FrissieKris/Eng_DesignProject_GantryCrane_Group-18/README.md

MCTR \
--Juan Fourie     -->   Pulley Mechanism \
--Romeo Mapasa    -->   Lateral Movement \
EEII \
--Jopie Roux      --> \
--JP Smith        --> \
REII  \
--Anton Swanepoel --> \
