FrissieKris/Eng_DesignProject_GantryCrane_Group-18/EngineeringDesign_Group18_Report/content/00_abstract.tex

% ── Abstract ────────────────────────────────────────────────
% The Abstract environment (defined in NWUStyle.sty):
%   • adds "Abstract" to the TOC
%   • sets page counter to 1 with roman numerals
%   • clears the page afterwards
\begin{Abstract}{}

This report presents the design, development, and testing of a gantry crane system for the transportation of steel metal sheets along a track.

\KeyWords{Pulley; Gantry Crane; Electro-magnet; Gearbox Design}

\end{Abstract}
