FrissieKris/Eng_DesignProject_GantryCrane_Group-18/EngineeringDesign_Group18_Report/content/04_interfaces.tex

% ============================================================
%  CHAPTER 4 – INTERFACES
% ============================================================
\chapter{Interface Control}
\label{ch:interface-control}
This chapter describes each of the interfaces introduced in chapter~\ref{ch:system-design}. Each interface listed in section~\ref{sec:summary-of-interfaces}, is described and allocated to a role in section~\ref{sec:work-allocation}.

\section{Work Allocation}
\label{sec:work-allocation}
This section ascribes each interface is the responsibility of the role under which it is described. Each member read and confirmed their responsibilities and interfaces under their jurisdiction as indicated below. By having their name printed next to their role they have accepted the responsibility and are the liable person for all interfaces listed in their section.

\subsection{EERI I:  }
\label{subsec:eeri1-interfaces}
EERI I Drive Electroncics by Jopie Roux.

Table \ref{tab1:interfaces-eeri1} and \ref{tab2:interfaces-eeri1} define the the external inteerfaces that 
cross the boundary of the drive electronics (F/U 1.1) and the internal interfaces bewtween
its level 2 functional units. The interface type letters correspond to figure \ref{fig:arch-eeri1}, where E denotes
electrical interfaces, S signal interfaces and M mechanical interfaces. 
The drive-electronics subsystem receives single-phase AC, distributes protected power to the 
required PSUs, receives control signals from REII, and supplies the three-phase induction 
motor used by MCTR II. It also returns conditioned current feedback to the controller and provides local 
hardware protection of the inverter.

\begin{table}[H]
    \centering
    \caption{External interfaces of EEII I (F/U 1.1, Level 1).}
    \label{tab1:interfaces-eeri1}

    \begin{tabularx}{\textwidth}{@{} l l l X @{}}
        \toprule
        \textbf{Interface} & \textbf{From} & \textbf{To} & \textbf{Description} \\
        \midrule

        I/F 1.0 E & F/U 2.0 & F/U 1.1.1 &
        Single-phase 230 VAC, 50 Hz mains input to the drive electronics. The input is routed through the required main switching and protection using 15 A trip switches before being distributed to the rest of the system. \\

        I/F 1.2 E & F/U 1.1.1 & F/U 1.2 &
        Protected mains supply to the 12 VDC power supply. \\

        I/F 1.6 E & F/U 1.1.1 & F/U 1.4 &
        Protected mains supply to the 12 VDC power supply. \\

        I/F 1.5 S & F/U 1.1 & F/U 1.1 &
        Control and feedback interface between the REII controller and the drive electronics. The controller provides isolated PWM signals used by the driver ICs to switch the DC bus voltage. EEII I returns a current-sense signal via an ACS72981xLR Hall-effect current sensor. The output voltage is limited below 2.048 V. \\

        I/F 1.7 E & F/U 1.1.5 & F/U 1.7 &
        Three-phase AC from the inverter to the 180 W induction motor. \\

        I/F 1.8 M & F/U 1.7 & F/U 1.3.1 &
        Mechanical transfer of motor torque from the 11 mm motor shaft to MCTR II's gearbox input. \\

        \bottomrule
    \end{tabularx}
\end{table}

\begin{table}[H]
    \centering
    \caption{Internal interfaces of EEII I (F/U 1.1, Level 2).}
    \label{tab2:interfaces-eeri1}

    \begin{tabularx}{\textwidth}{@{} l l l X @{}}
        \toprule
        \textbf{Interface} & \textbf{From} & \textbf{To} & \textbf{Description} \\
        \midrule

        I/F 1.1.1 E & F/U 1.1.1 & F/U 1.1.2 &
        Protected single-phase 230 VAC supplied to the rectifier stage after the system protection and switching
        devices.\\

        I/F 1.1.2 E & F/U 1.1.2 & F/U 1.1.3 &
        High voltage rectified DC supplied to the DC bus for smoothing with a bulk capacitor.\\

        I/F 1.1.3 E & F/U 1.1.3 & F/U 1.1.5 &
        Smooth HV DC voltage supplied to the 6 switch inverter.\\

        I/F 1.1.4 S & F/U 1.1.4 & F/U 1.1.5 &
        Isolated PWM signals used to contorl the IGBT switching. The IR2104 gate driver ICs are used to switch
        the IGBTs using the provided PWM signal. Between the REII controller and the IR2104s a optocoupler is 
        inserted to ensure electrical isolation.\\

        I/F 1.1.5 S & F/U 1.1.5 & F/U 1.1.6 &
        Inverter operating current information sent to the sensing and protection stage using a 
        ACS72981xLR Hall-effect current sensor. This path is used to detect a overcurrent or shoot-through fault 
        and initialte a local inverter shutdown.\\

        I/F 1.1.6 E & F/U 1.2 & F/U 1.1.4 &
        12VDC used to power the driver ICs obtained from EEII II's PSU. \\

        \bottomrule
    \end{tabularx}
\end{table}

The main power path flows from the protected mains to the bridge rectifier, to the DC bus for smoothing using a bulk
capacitor to supply the 3-phase inverter. In parallel, a 12VDC PSU powers the gate driver ICs which use the isolated 
PWM singals from REII to switch the IBTSs and create the 3-phase AC for the induction motor. The EEII I subsystem
also provides a current-sense signal to REII for feedback and local protection of the inverter. 

\subsection{EERI II: Magnetic Load Attachment Interfaces}
\label{subsec:eeri2-interfaces}
The EERI II subsystem interfaces with the embedded controller, the main power distribution, the hoisting assembly, and the physical electromagnet.
The interface allocations are the work of J.P. Smith and are detailed in Tables~\ref{tab:interfaces-eeri2} (Level~1 external interfaces) and~\ref{tab:interfaces-eeri2-internal} (Level~2 internal interfaces).
Power enters via I/F~1.2~E from the EEII~I power supply $+13.5\,\text{V}$ DC to the switching circuit and electromagnet coils.
The physical assembly is suspended from the MCTR~II hoisting system via mechanical interface I/F~1.3~M.
Command and feedback signals are exchanged with the REII ESP32-S3 controller across I/F~1.10~S, which carries PWM gate switching command and returns the analog current-sense signal ($V_{\mathrm{ISENSE}} \le 2.048\,\text{V}$).
Internally, the driver stage switches the coils over I/F~1.2.1~E,
the current passes through the ACS712 sensor over I/F~1.2.2~E,
and regulated $+5\,\text{V}$ and ground are shared between the switching and analog conditioning circuit over I/F~1.2.3~E.
Finally, electromagnetic force ($\ge 268.68\,\text{N}$) is applied to the 20\,kg metal plate across mechanical interface I/F~5.0~M.
\begin{table}[H]
    \centering
    \caption{External interfaces of EERI II (F/U 1.2, Level 1).}
    \label{tab:interfaces-eeri2}
    \begin{tabularx}{\textwidth}{@{} l l l X @{}}
        \toprule
        \textbf{Interface} & \textbf{From} & \textbf{To} & \textbf{Description} \\
        \midrule
        I/F 1.2 E  & F/U 1.1.1 & F/U 1.2.2 & $+13.5\,\text{V}$ DC power supply rail and ground from EEII I, rated for $100\,\text{W}$. \\
        I/F 1.3 M  & F/U 1.4   & F/U 1.2.1 & Mechanical connection between the electromagnet and the MCTR II hoist cable. \\
        I/F 1.10 S & F/U 1.5   & F/U 1.2   & Control and feedback interface with the REII controller, 3.3\,V PWM switching command to F/U 1.2.2 and a conditioned analog current-sense signal ($V_{\mathrm{ISENSE}} \le 2.048\,\text{V}$) from F/U 1.2.3. \\
        I/F 5.0 M  & F/U 1.2.1 & Payload   & Electro magnet - Plate interface with $\ge 268.68\,\text{N}$ of holding force across the 3 U cores, 6 poles, on the 20\,kg flat steel plate (PHY1). \\
        \bottomrule
    \end{tabularx}
\end{table}

\begin{table}[H]
    \centering
    \caption{Internal interfaces of EERI II (F/U 1.2, Level 2).}
    \label{tab:interfaces-eeri2-internal}
    \begin{tabularx}{\textwidth}{@{} l l l X @{}}
        \toprule
        \textbf{Interface} & \textbf{From} & \textbf{To} & \textbf{Description} \\
        \midrule
        I/F 1.2.1 E & F/U 1.2.2 & F/U 1.2.1 & Switched driver delivering up to 3.1\,A at 13.5\,V) from the IRF540Z low-side switch to the 6 series coils. \\
        I/F 1.2.2 E & F/U 1.2.1 & F/U 1.2.3 & Coil current through the ACS712-30A Hall-effect sensor. \\
        I/F 1.2.3 E & F/U 1.2.2 & F/U 1.2.3 & Regulated $+5\,\text{V}$ DC and analog ground powering the ACS712 sensor and LM358 opamp stages. \\
        \bottomrule
    \end{tabularx}
\end{table}

\subsection{MCTR I: Romeo Mapasa }
\label{subsec:mctr1-interfaces}
MCTR I Lateral Movement by Romeo Mapasa.
\begin{table}[H]
    \centering
    \caption{Operational Interfaces.}
    \label{tab:interfaces-mctr1}
    \begin{tabular}{@{} l l l p{5cm} @{}}
        \toprule
        \textbf{Interface} & \textbf{From} & \textbf{To} & \textbf{Description} \\
        \midrule
        I1 & F/U 1.0 & F/U 2.0 & [Description of data/power/signal.] \\
        I2 & F/U 2.0 & F/U 3.0 & [Description.] \\
        \bottomrule
    \end{tabular}
\end{table}

\subsection{MCTR II: Juan Fourie}
\label{subsec:mctr2-interfaces}
MCTR II Spooling by Juan Fourie.
\input{content/0p0_mctr2_parameters}

% ---- INSERTED FROM DRAWINGS: Level 1 and Level 2 (MCTR II) -------------
Tables~\ref{tab:interfaces-mctr2} and~\ref{tab:interfaces-mctr2-internal} list every interface that crosses the
MCTR II boundary (Level 1 numbering) and every interface between its internal
functional units (Level 2 numbering). The type letter follows the drawing:
M = mechanical, E = electrical, S = signal. Entries marked
\textcolor{red}{TBD} remain to be confirmed against subsequent design drawings and tests.
 
\begin{table}[H]
    \centering
    \caption{External interfaces of MCTR II (F/U \fuMII, Level 1).}
    \label{tab:interfaces-mctr2}
    \footnotesize
    \renewcommand{\arraystretch}{1.25}
    \begin{tabularx}{\textwidth}{@{} l p{2.6cm} p{1.6cm} X @{}}
        \toprule
        \textbf{Interface} & \textbf{From} & \textbf{To} & \textbf{Description and key parameters} \\
        \midrule
        I/F 1.1 M & F/U 1.3 & F/U \fuMII &
            Bolted mounting of the of the loadcell with pulley to MCTR I. Plate carries the rope reaction of
            \showv{FropeD}{0}{N} (design case). Preliminary design will be M12 bolt hole for eyebolts. This interface also includes the mounting of the gearbox to be mounted on MCTR I. Final gearbox dimensions \tbd{Gearbox Dimensions} \\
        I/F 1.3 M & F/U \fuMII.4 (rope) & F/U 1.2 &
            Rope termination to the magnetic load attachment. Rated payload
            \InMassRated\,kg plus attachment 10kg conservative headroom for EEII II components. \\
        I/F 1.7 E & F/U 1.1 & F/U \fuMII &
            3-phase power to the induction motor from the VSD
            (\InMotorP\,W, \InMotorN\,rpm at \InMotorF\,Hz). Frequency designed for is 30Hz, 816Rom for reduction ratio of 26.7:1. Delivered
            frequency \tbd{Hz}. Mains feed to the Brake PSU. \\
        I/F 1.8 M & F/U 1.1 (motor) & F/U \fuMII.1 &
            Motor shaft (11\,mm, $4\times16$\,mm keyway) to gearbox input
            shaft (\InShaftD\,mm) through a flexible coupling and a separate
            input stub shaft on its own bearings. Flexible spider coupling 11mm adapted to 10mm. \\
        I/F 1.9 S & F/U \fuMII.6 & F/U 1.5 &
            HX711 digital output (DOUT/SCK), 24-bit, \InSps\,SPS, logic level
            3.3 V as agreed to date with REII. Load reading used for telemetry and interlock. \\
        I/F 1.10 S & F/U 1.5 & F/U \fuMII.3 &
            Brake release command. Active-high releases; the
            default (reset, watchdog, power loss) is brake engaged, in
            hardware. \\
        \bottomrule
    \end{tabularx}
\end{table}
 
\begin{table}[H]
    \centering
    \caption{Internal interfaces of MCTR II (F/U \fuMII, Level 2).}
    \label{tab:interfaces-mctr2-internal}
    \footnotesize
    \renewcommand{\arraystretch}{1.25}
    \begin{tabularx}{\textwidth}{@{} l p{2.6cm} p{1.6cm} X @{}}
        \toprule
        \textbf{Interface} & \textbf{From} & \textbf{To} & \textbf{Description and key parameters} \\
        \midrule
        I/F \fuMII.1 M & F/U \fuMII.1 & F/U \fuMII.4 &
            Gearbox output shaft to drum hub. Design torque \showv{TdrD}{1}{N\,m} (\InMassDesign\,kg
            overload with service factor \InServiceF). \\
        I/F \fuMII.2 E & F/U \fuMII.2 & F/U \fuMII.3 &
            48\,V DC supply to the brake coil through switching circuit, with
            flyback suppression. Coil current \tbd{A}. \\
        I/F \fuMII.3 M & F/U \fuMII.3 & F/U \fuMII.1 &
            Brake on the gearbox between two stages, so that one gear stage carries part of the load (provisional;
            drum shaft is the alternative). Required rating
            \showv{BrakeReqIn}{2}{N\,m} (input shaft) or
            \showv{BrakeReqDrum}{1}{N\,m} (drum shaft), safety factor
            \InBrakeSF. \\
        I/F \fuMII.4 M & F/U \fuMII.4 & F/U \fuMII.5 &
            Rope over a sheave suspended from the load cell. Vertical load
            \showv{Fcell}{0}{N} at rated payload\\
        I/F \fuMII.5 S & F/U \fuMII.5 & F/U \fuMII.6 &
            4-wire bridge signal, \InCellSens\,mV/V rated output, shielded
            cable, full-scale \showv{SigFS}{1}{mV} against an ADC range of
            \showv{AdcRange}{1}{mV}. \\
        \bottomrule
    \end{tabularx}
\end{table}

\subsection{REII: Anton Swanepoel}
\label{subsec:reii-interfaces}
REII Remote Control Dashboard by Anton Swanepoel.

Tables~\ref{tab:reii-external} and~\ref{tab:reii-internal}
define the proposed external and internal interfaces in Figure~3.5.
TBD parameters require agreement.
\cite{nwu_sysrs2026,nwu_reii_scope2026}

\begingroup
\setlength{\tabcolsep}{4pt}
\renewcommand{\arraystretch}{1.15}

\begin{table}[H]
    \centering
    \footnotesize
    \caption{External interfaces of REII (F/U 1.5, Level 1).}
    \label{tab:reii-external}

    \begin{tabularx}{\textwidth}{@{}
        >{\raggedright\arraybackslash}p{2.15cm}
        >{\raggedright\arraybackslash}p{2.7cm}
        >{\raggedright\arraybackslash}p{2.9cm}
        >{\raggedright\arraybackslash}X
    @{}}
        \toprule
        \textbf{Interface} &
        \textbf{From} &
        \textbf{To} &
        \textbf{Description and key parameters} \\
        \midrule

        Operator link\newline (1.5.1) &
        Operator &
        Python dashboard\newline (F/U 1.5.1) &
        Operator commands enter; displayed telemetry and faults return.
        \\[3pt]

        Ground supply\newline (1.5.2) &
        PC supply &
        Ground station and radio\newline (F/U 1.5.2, 1.5.3) &
        PC USB power supplies the UART-connected ground station;
        its radio uses regulated 3.3~V.
        \\[3pt]

        Crane supply\newline (1.5.3) &
        Crane supply &
        Controller and hoist radio\newline (F/U 1.5.5, 1.5.4) &
        Regulated 5~V would feed the S3 board; its 3.3~V
        peripheral rail would supply the radio.
        \\[3pt]

        Inverter control\newline (1.5.4) &
        ESP32-S3 controller\newline (F/U 1.5.5) &
        Drive electronics\newline (F/U 1.1) &
        Six isolated PWM paths plus reserve; current feedback
        below 2.048~V for fault inference.
        \textcolor{red}{[TBD: PWM timing and active levels.]}
        \\[3pt]

        Magnet control\newline (1.5.5) &
        ESP32-S3 controller\newline (F/U 1.5.5) &
        Magnetic attachment\newline (F/U 1.2) &
        Isolated magnet PWM; current feedback below 2.048~V
        for investigating an on-load indicator.
        \textcolor{red}{[TBD: current-signature discrimination,
        calibration and load-support criterion.]}
        \\[3pt]

        Lateral control\newline (1.5.6) &
        ESP32-S3 controller\newline (F/U 1.5.5) &
        Lateral movement\newline (F/U 1.3) &
        PWM and direction commands; quadrature encoder feedback
        for lateral position and speed.
        \textcolor{red}{[TBD: encoder scale and polarity.]}
        \\[3pt]

        Spooling interface\newline (1.5.7) &
        ESP32-S3 controller\newline (F/U 1.5.5) &
        Spooling subsystem\newline (F/U 1.4) &
        REII would power the HX711 (3.3~V/GND), drive SCK
        and read DAT. The proposed optocoupler brake command
        is HIGH to release and LOW to hold; loss of brake
        power would engage the brake. Group links:
        I/F~1.9 load and I/F~1.10 brake.
        \textcolor{red}{[TBD: load calibration and final brake polarity.]}
        \\[3pt]

        Protection status\newline (1.5.8) &
        Local protection &
        ESP32-S3 controller\newline (F/U 1.5.5) &
        The hardware E-stop would remove power from the drive
        electronics independently of software (PHY2).A proposed status signal
        would inform the ESP32-S3 when the E-stop is activated.
        \textcolor{red}{[TBD: E-stop wiring, status signal and
        integration testing.]}
        \\

        \bottomrule
    \end{tabularx}
\end{table}

\begin{table}[H]
    \centering
    \footnotesize
    \caption{Internal interfaces of REII (F/U 1.5, Level 2).}
    \label{tab:reii-internal}

    \begin{tabularx}{\textwidth}{@{}
        >{\raggedright\arraybackslash}p{2.15cm}
        >{\raggedright\arraybackslash}p{2.7cm}
        >{\raggedright\arraybackslash}p{2.9cm}
        >{\raggedright\arraybackslash}X
    @{}}
        \toprule
        \textbf{Interface} &
        \textbf{From} &
        \textbf{To} &
        \textbf{Description and key parameters} \\
        \midrule

        PC serial link\newline (1.5.1.1) &
        Python dashboard\newline (F/U 1.5.1) &
        STM32 ground station\newline (F/U 1.5.2) &
        UART serial requests; replies and diagnostics return
        at 115200~bit/s, 8N1.
        \\[3pt]

        Ground radio SPI\newline (1.5.2.1) &
        STM32 ground station\newline (F/U 1.5.2) &
        Ground radio\newline (F/U 1.5.3) &
        SPI and radio-control signals; received frames and
        radio status return.
        \\[3pt]

        Wireless link\newline (1.5.3.1) &
        Ground radio\newline (F/U 1.5.3) &
        Hoist radio\newline (F/U 1.5.4) &
        Bidirectional nRF24 link carrying commands, results
        and operational telemetry.
        \\[3pt]

        Hoist radio SPI\newline (1.5.4.1) &
        Hoist radio\newline (F/U 1.5.4) &
        ESP32-S3 controller\newline (F/U 1.5.5) &
        Received commands pass to the controller; SPI control
        and reply data return.
        \\

        \bottomrule
    \end{tabularx}
\end{table}

\endgroup

\noindent
Controller logic operates at 3.3~V.
\cite{nwu_s3_board2026}
