FrissieKris/Eng_DesignProject_GantryCrane_Group-18/EngineeringDesign_Group18_Report/content/03_system_design.tex

% ============================================================
%  CHAPTER 3 – System Design
% ============================================================
\chapter{System Design}
\label{ch:system-design}
This chapter divides the work amongst 5 engineering students according to their role presented by their degree. Each of the roles are responsible for a functional section of the design. Section~\ref{sec:functional-flow} covers the functional flow diagrams of the system. Section~\ref{sec:system-architecture} gives the overview of the system design with the top-most architecture, which is then split amongst the five roles in Section~\ref{sec:functional-units} (subsections~\ref{subsec:eeri1-fu1p1} to \ref{subsec:reii-fu1p5}).

\section{Functional Flow Diagrams}
\label{sec:functional-flow}

The flow system operation runs from development, deployment, mounting, operation and maintenance until its decomission or failure as indicated in figure~\ref{fig:ffd-lifecycle}.

\begin{figure}[H]
    \centering
    
    \caption{Functional flow diagram illustrating the system life-cycle.}
    \label{fig:ffd-lifecycle}
\end{figure}

\subsection{Level 0 System Architecture}
\label{subsec:top-level-system}
The top level 0 archictecture of the system entails its interaction through the operator, support rail, power grid, environment and the payload as in figure~\ref{fig:arch-level0}

\begin{figure}[H]
    \centering
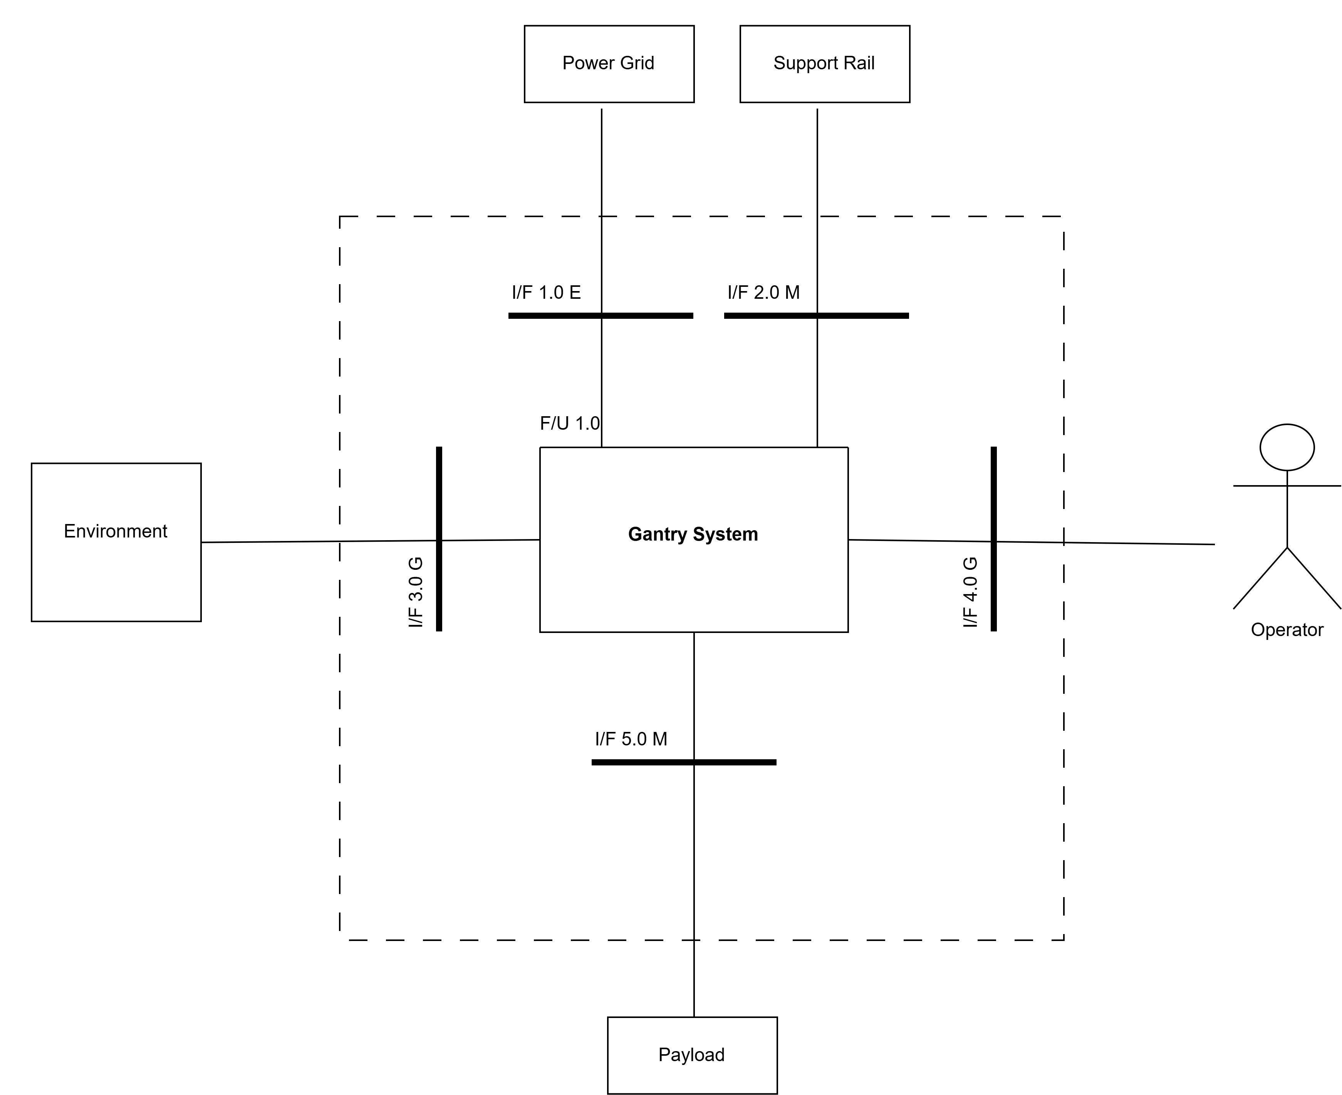
[picture p2: EngineeringDesign_Group18_Report/figures/Fig_Arch_Level0.png]
    
    \caption{System Architecture on Level 0}
    \label{fig:arch-level0}
\end{figure}

\subsection{Level 1: Gantry System F/U 1.0}
\label{subsec:gantry-system-fu}
The gantry system itself is divided up into five functional units as per the roles assigned to each group member as displayed in figure~\ref{fig:arch-level1}. Their subsequent interfaces and lower level functional units are covered by each member responsible.
\begin{figure}[H]
    \centering
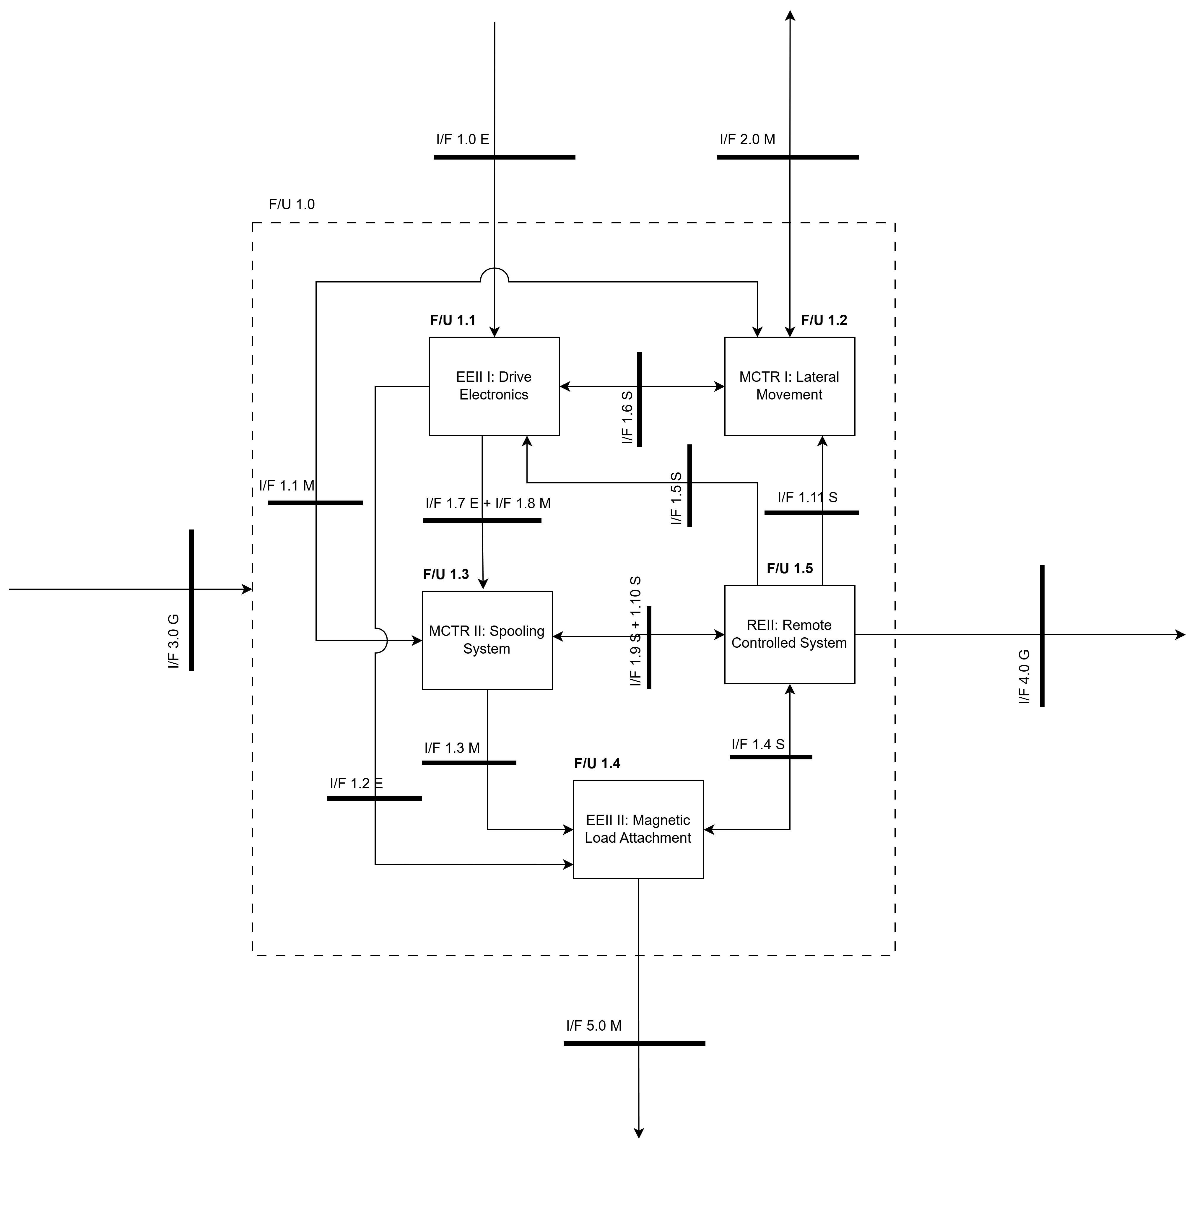
[picture p3: EngineeringDesign_Group18_Report/figures/Fig_Arch_Level1_GantrySystem.png]
    
    \caption{System Architecture on Level 1}
    \label{fig:arch-level1}
\end{figure}

\section{Level 2: Functional Units}
\label{sec:functional-units}
Each subsection handles one of the first level functional units introduced in section~\ref{sec:functional-units}.

\subsection{EERI I: Drive Electronics: F/U 1.1}
\label{subsec:eeri1-fu1p1}
EERI I Drive Electroncics by Jopie Roux.

The drive electronics subsystem converts the available single-phase 230VAC main supply to a 
controlled 3-phase supply for the induction motor. This interfaces with MCTR II through I/F 1.7 E
and 1.8 M. Figure~\ref{fig:arch-eeri1} shows the internal architecture of the subsystem and 
Table~\ref{tab:functional-units-eeri1} lists its three functional units. I additon to supplying them motor
EEII I is responsible for mains protection and distirubtion to the low voltage power supplies.
The subsystem also provides local protection against overcurrent and shoot-through conditions and
supplies current measurement feedback to the REII controller.

\begin{figure}[H]
    \centering
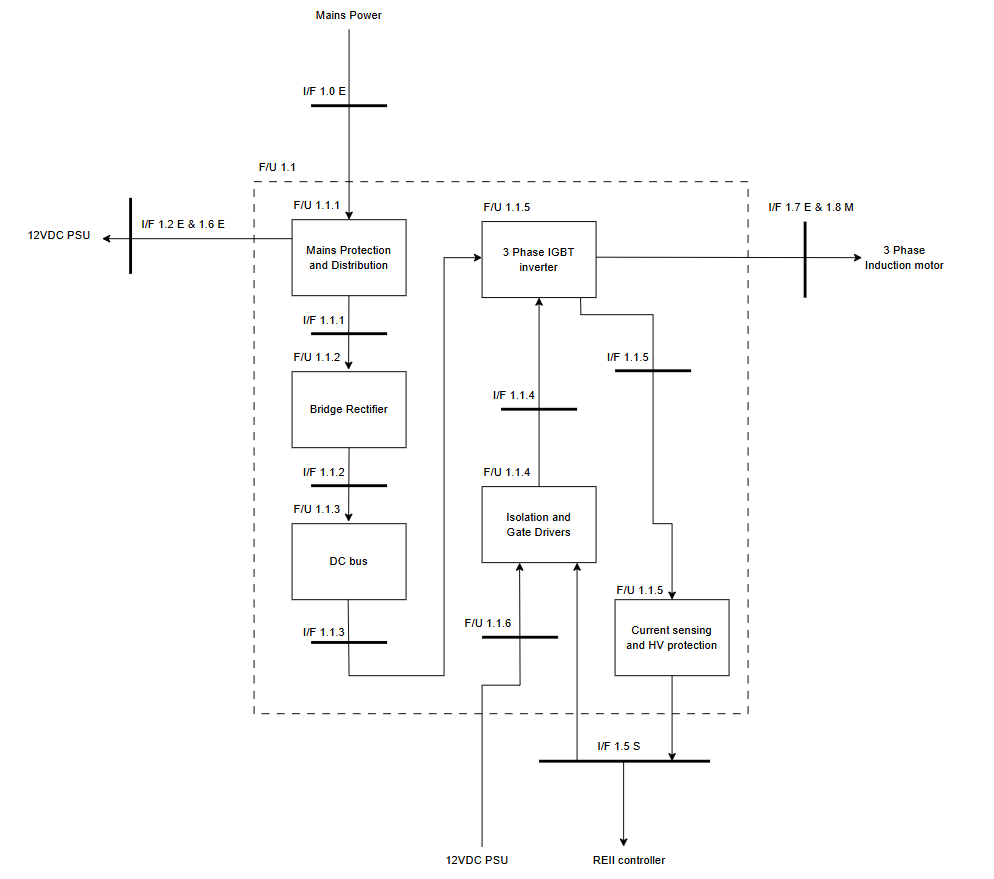
[picture p4: EngineeringDesign_Group18_Report/figures/Fig_Arch_Level2_EEII1.png]
    
    \caption{System Architecture of F/U 1.1 of the Drive Electronics Subsystem}
    \label{fig:arch-eeri1}
\end{figure}

\begin{table}[H]
    \centering
    \caption{Operational Functional Units.}
    \label{tab:functional-units-eeri1}
    \begin{tabular}{@{} l l p{7cm} @{}}
        \toprule
        \textbf{F/U ID} & \textbf{Name} & \textbf{Description} \\
        \midrule
        F/U 1.0 & [Subsystem A] & [What this functional unit does.] \\
        F/U 2.0 & [Subsystem B] & [What this functional unit does.] \\
        F/U 3.0 & [Subsystem C] & [What this functional unit does.] \\
        \bottomrule
    \end{tabular}
\end{table}

\subsection{EERI II: Magnetic Load Attachment: F/U 1.2}
\label{subsec:eeri2-fu1p2}
The EERI II subsystem, engineered by J.P. Smith,
provides electromagnetic payload retention,
fast power switching and analog current sensing.
The subsystem decomposes into four lower level functional units (Table~).\ref{tab:functional-units-eeri2}.

\begin{table}[H]
    \centering
    \caption{EERI II Operational Functional Units.}
    \label{tab:eeri2-functional-units}
    \begin{tabular}{@{} l l p{8.5cm} @{}}
        \toprule
        \textbf{F/U ID} & \textbf{Name} & \textbf{Description} \\
        \midrule
        F/U 1.2.1 & Magnetic Circuit \& Coils & Three-point U-core electromagnet assembly incorporating six custom bobbins ($28\,\text{m}$ of $1.0\,\text{mm}$ OD enamelled copper wire each, 286~turns/spool) providing $\ge 268.7\,\text{N}$ static holding capacity on $\ge 5\,\text{mm}$ steel plates. \\
        F/U 1.2.2 & Power Switching \& Gate Drive & High-current low-side switching stage using an IRF540Z power MOSFET driven by a TC4420 6\,A non-inverting driver from the $+13.88\,\text{V}$ rail, protected by an MBR1060 Schottky flyback diode. \\
        F/U 1.2.3 & Current Sensing \& Conditioning & Galvanically isolated COTS ACS712-30A Hall-effect module conditioned via dual LM358 op-amp differential gain and offset subtraction, scaling $0\text{--}3\,\text{A}$ to $0.015\text{--}1.980\,\text{V} \le 2.048\,\text{V}$. \\
        \bottomrule
    \end{tabular}
\end{table}

\subsection{MCTR I: Lateral Movement: F/U 1.3}
\label{subsec:mctr1-fu1p3}
MCTR I Lateral Movement by Romeo Mapasa.
\begin{table}[H]
    \centering
    \caption{Operational Functional Units.}
    \label{tab:functional-units-mctr1}
    \begin{tabular}{@{} l l p{7cm} @{}}
        \toprule
        \textbf{F/U ID} & \textbf{Name} & \textbf{Description} \\
        \midrule
        F/U 1.0 & [Subsystem A] & [What this functional unit does.] \\
        F/U 2.0 & [Subsystem B] & [What this functional unit does.] \\
        F/U 3.0 & [Subsystem C] & [What this functional unit does.] \\
        \bottomrule
    \end{tabular}
\end{table}

\subsection{MCTR II: Spooling: F/U 1.4}
\label{subsec:mctr2-fu1p4}
MCTR II Spooling by Juan Fourie.
\input{content/0p0_mctr2_parameters}

The spooling subsystem raises and lowers the payload on a rope wound onto a
drum, holds it safely when unpowered, and reports the on-hook load to the
controller. Figure~\ref{fig:arch-mctr2} shows its internal architecture and
Table~\ref{tab:fu-mctr2} lists its six functional units. The induction motor
that drives the gearbox is supplied and powered by EEII~I and enters this
subsystem through interface I/F~1.7~E and I/F~1.8~M. The gearbox and spool itself is mounted to the frame of MCTR~I through I/F~1.1~M. The brake signal is received from REII through I/F~1.9~S and the load cell telemetry with the power and ground required by the HX711 is sent and received by REII through I/F~1.10~S. EERI~II has its electromagnet and electrical/signal wiring connected through I/F~1.3~M.
(Chapter~\ref{ch:interface-control}).

\begin{figure}[H]
    \centering
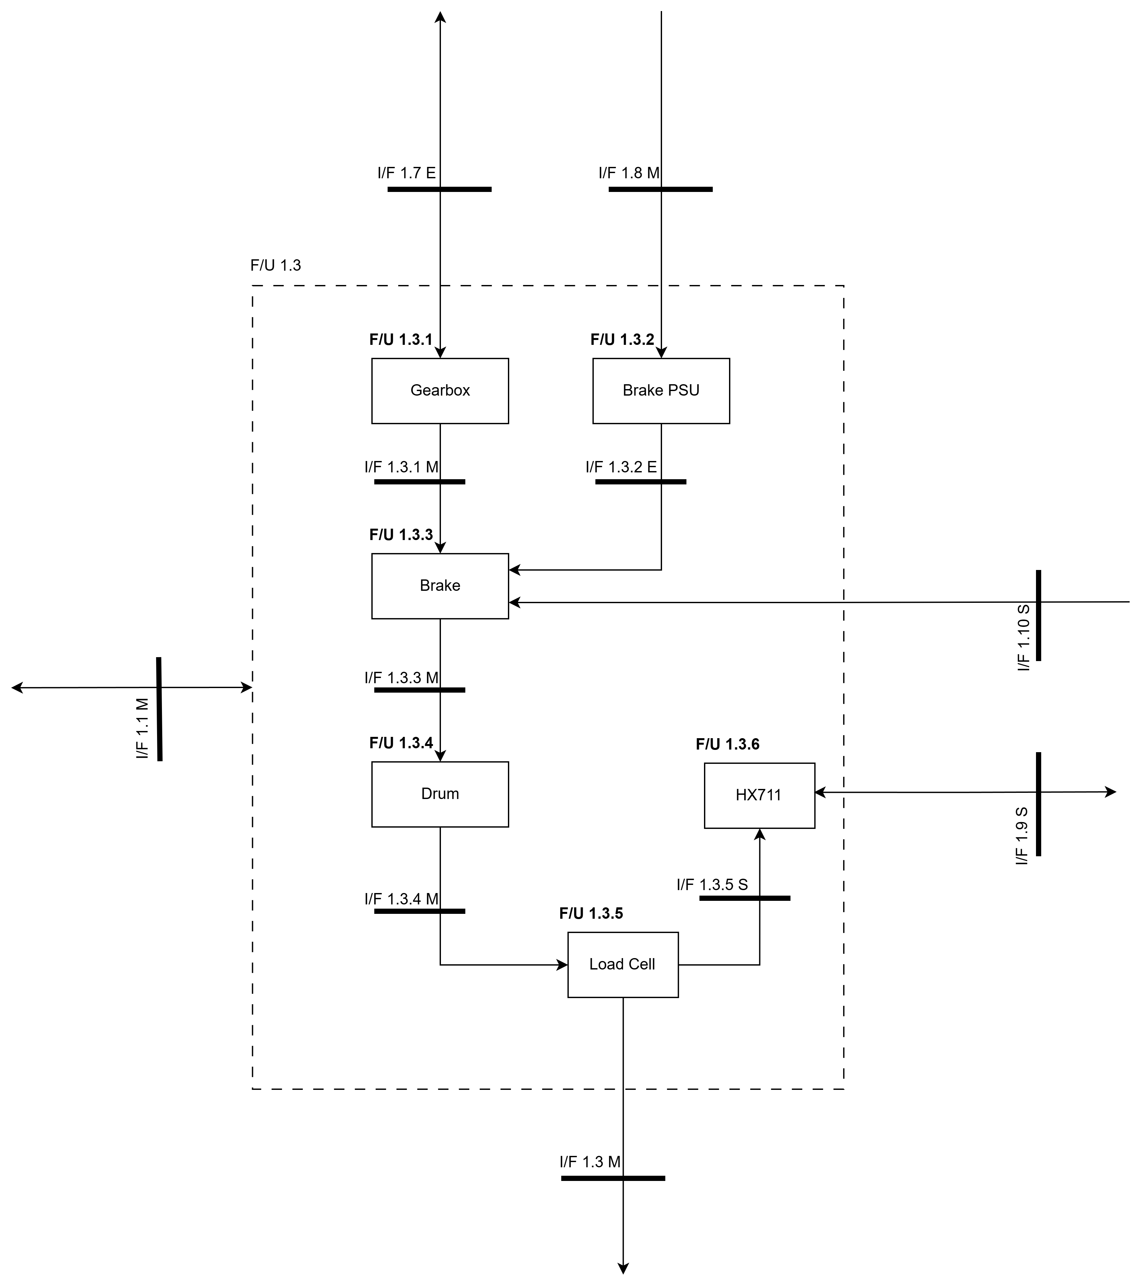
[picture p5: EngineeringDesign_Group18_Report/figures/Fig_Arch_Level2_MCTRII.png]
    
    \caption{System Architecture of F/U 1.4 of the Spooling Subsystem}
    \label{fig:arch-mctr2}
\end{figure}

\begin{table}[H]
    \centering
      \caption{Functional units of the MCTR II spooling subsystem (F/U \fuMII).}
    \label{tab:fu-mctr2}
    \small
    \begin{tabularx}{\textwidth}{@{} l l X @{}}
        \toprule
        \textbf{F/U ID} & \textbf{Name} & \textbf{Description} \\
        \midrule
        F/U \fuMII.1 & Gearbox &
            Two-stage compound spur gearbox (3D-printed PETG, no worm gear,
            DR2). Reduces motor speed (\showv{Nmot}{0}{rpm}) by an overall
            ratio of \shown{iT}{2}:1 to \showv{Ndrum}{1}{rpm} at the drum and
            multiplies motor torque to \showv{TdrR}{2}{N\,m} (rated load). \\
        F/U \fuMII.2 & Brake PSU &
            Stand-alone 48\,V DC supply for the brake coil, fed from the
            mains distribution provided by EEII~I. Switched through a relay
            that defaults to the de-energised state. \\
        F/U \fuMII.3 & Brake &
            Spring-applied, electrically released holding brake. Engages
            automatically on loss of power or command and holds the payload
            without drift (FR6). \\
        F/U \fuMII.4 & Drum &
            \InDrumD\,mm drum carrying \InRopeD\,mm rope in a single layer
            (\shown{Wraps}{1} wraps for the \InStroke\,m stroke, capacity
            \shown{WrapsFit}{0} wraps). Output shaft of the gearbox drives it
            through a hub with a cross-bolt. \\
        F/U \fuMII.5 & Load cell &
            S-type load cell (\InCellCap\,kg) carrying a sheave through which
            the rope passes; measures the on-hook load for telemetry and
            overload interlock (FR5). \\
        F/U \fuMII.6 & HX711 &
            24-bit bridge ADC converting the load-cell signal to a 2-wire
            digital stream (\InSps\,SPS) for the controller. \\
        \bottomrule
    \end{tabularx}
\end{table}

\subsection{REII: Remote Control Dashboard: F/U 1.5}
\label{subsec:reii-fu1p5}
REII Remote Control Dashboard by Anton Swanepoel

The proposed REII subsystem would provide crane commands and display
lateral position, speed, load, current, fault and the current grip status.
Figure~\ref{fig:reii-architecture} shows the architecture;
Table~\ref{tab:functional-units-reii} lists five functional units.
Commands would pass from the Python dashboard through the STM32 UART
ground station and nRF24 radios to the ESP32-S3; telemetry would return
along this path. \cite{nwu_sysrs2026,nwu_reii_scope2026}

I/F~1.5.4 would link the controller to EERI~I's inverter, while
I/F~1.5.5 would connect it to EERI~II's magnet. Both would return
current feedback for fault or grip inference. MCTR~I would receive
lateral commands and return encoder feedback through I/F~1.5.6.
Through I/F~1.5.7, REII would command MCTR~II's brake, power the HX711,
drive SCK and read DAT. Chapter~\ref{ch:interface-control} details these
interfaces. Final integration remains incomplete.
\cite{nwu_sysrs2026,nwu_reii_scope2026,nwu_s3_board2026}

\begin{table}[H]
    \centering
    \caption{Operational functional units of REII.}
    \label{tab:functional-units-reii}
    \begin{tabularx}{\textwidth}{@{}
        l
        >{\raggedright\arraybackslash}p{4cm}
        >{\raggedright\arraybackslash}X
    @{}}
        \toprule
        \textbf{F/U ID} & \textbf{Name} & \textbf{Description} \\
        \midrule
        F/U~1.5.1 & Python dashboard &
        Accept operator commands and display telemetry and faults. \\

        F/U~1.5.2 & STM32 ground station &
        Transfer messages between the PC serial connection and the radio. \\

        F/U~1.5.3 & Ground radio &
        Send commands and receive controller replies. \\

        F/U~1.5.4 & Hoist radio &
        Receive commands and return results and telemetry. \\

        F/U~1.5.5 & ESP32-S3 controller &
        Check requests, generate control outputs and collect subsystem data. \\
        \bottomrule
    \end{tabularx}
\end{table}

\begin{figure}[H]
    \centering
    \includegraphics[width=0.85\textwidth]
        {figures/Figure_3_5_System_Architecture.png}
    \caption{Proposed system architecture of REII F/U~1.5.}
    \label{fig:reii-architecture}
\end{figure}

\section{Summary of Interfaces}
\label{sec:summary-of-interfaces}
This section lists each of the interfaces introduced above organised according to their nature, which is either mechanical, electrical, signal, or general. These interfacees are then assigned to each role in chapter \ref{ch:interface-control}.

\subsection{Mechanical Interfaces}
\label{subsec:mechanical-interfaces}
\begin{itemize}
    \item \textbf{MCTR II:} I/F 1.1~M (hoist baseplate to MCTR I mounting plate), I/F 1.3~M (rope to magnetic attachment), I/F 1.8~M (motor shaft to gearbox), and internal I/F \fuMII.1~M (gearbox to drum), \fuMII.3~M (brake to shaft), \fuMII.4~M (rope to load cell).
\end{itemize}

\subsection{Electrical Interfaces}
\label{subsec:electrical-interfaces}
\begin{itemize}
    \item \textbf{MCTR II:} I/F 1.7~E (motor power from EEII~I) and internal I/F \fuMII.2~E (Brake PSU to brake coil).
\end{itemize}

\subsection{Signal Interfaces}
\label{subsec:signal-interfaces}
\begin{itemize}
    \item \textbf{MCTR II:} I/F 1.9~S (HX711 to controller), I/F 1.10~S (brake release command) and internal I/F \fuMII.5~S (load cell to HX711).
\end{itemize}

\subsection{General Interfaces}
\label{subsec:general-interfaces}
