FrissieKris/Eng_DesignProject_GantryCrane_Group-18/Latex_Report/content/04_concept.tex

% ============================================================
%  CHAPTER 4 – CONCEPT DESIGN
% ============================================================
\chapter{Concept Design}
\label{ch:concept}

[Describe the high-level solution strategy. Focus on \textit{what}
the system must do, not yet \textit{how} it will do it. Use
functional flow diagrams and architecture diagrams to illustrate
the concept.]

\section{Functional Flow Diagrams}
\label{sec:functional-flow}

[Describe the life-cycle and operational flows of the system.
Reference each diagram in the text before it appears.]

\begin{figure}[H]
    \centering
    
    \caption{Functional flow diagram illustrating the system life-cycle.}
    \label{fig:ffd-lifecycle}
\end{figure}

\begin{figure}[H]
    \centering
   % \includegraphics[width=0.80\textwidth]{functional_flow_operational}
    \caption{Functional flow diagram illustrating the operational flow.}
    \label{fig:ffd-operational}
\end{figure}

\section{System Architecture}
\label{sec:architecture}

[Describe the operational levels of the system (Level 0, Level 1,
Level 2, etc.) with a block diagram for each.]

\begin{figure}[H]
    \centering
    %\includegraphics[width=0.70\textwidth]{architecture_L0}
    \caption{Operational Level 0 architecture.}
    \label{fig:arch-l0}
\end{figure}

\begin{table}[H]
    \centering
    \caption{Operational Functional Units.}
    \label{tab:functional-units}
    \begin{tabular}{@{} l l p{7cm} @{}}
        \toprule
        \textbf{F/U ID} & \textbf{Name} & \textbf{Description} \\
        \midrule
        F/U 1.0 & [Subsystem A] & [What this functional unit does.] \\
        F/U 2.0 & [Subsystem B] & [What this functional unit does.] \\
        F/U 3.0 & [Subsystem C] & [What this functional unit does.] \\
        \bottomrule
    \end{tabular}
\end{table}

\begin{table}[H]
    \centering
    \caption{Operational Interfaces.}
    \label{tab:interfaces}
    \begin{tabular}{@{} l l l p{5cm} @{}}
        \toprule
        \textbf{Interface} & \textbf{From} & \textbf{To} & \textbf{Description} \\
        \midrule
        I1 & F/U 1.0 & F/U 2.0 & [Description of data/power/signal.] \\
        I2 & F/U 2.0 & F/U 3.0 & [Description.] \\
        \bottomrule
    \end{tabular}
\end{table}
