FrissieKris/Eng_DesignProject_GantryCrane_Group-18/Latex_Report/content/00_abstract.tex

% ── Abstract ────────────────────────────────────────────────
% The Abstract environment (defined in NWUStyle.sty):
%   • adds "Abstract" to the TOC
%   • sets page counter to 1 with roman numerals
%   • clears the page afterwards
\begin{Abstract}{}

This report presents the design, development, and testing of a gantry crane system for the transportation of steel metal sheets along a track.

[Replace this placeholder with a 200–350 word summary covering:
(1) the problem and its significance,
(2) the design approach taken,
(3) key results and how they relate to the requirements, and
(4) main conclusions and future work recommendations.]

\KeyWords{Pulley; Gantry Crane; Electro-magnet; Gearbox Design}

\end{Abstract}
