FrissieKris/Eng_DesignProject_GantryCrane_Group-18/Latex_Report/content/05_preliminary.tex

% ============================================================
%  CHAPTER 5 – PRELIMINARY DESIGN
% ============================================================
\chapter{Preliminary Design}
\label{ch:preliminary}

[Expand the concept into specific subsystem decisions. For each
functional unit, identify candidate technologies or components,
evaluate them against the requirements, and select and justify
the best option.]

\section{Preliminary Hardware Decisions}
\label{sec:prelim-hw}

% ── Subsystem 1 ─────────────────────────────────────────────
\subsection{[Subsystem 1 – e.g. Imaging Module]}
\label{subsec:prelim-imaging}

[Discuss the criteria for selecting this component (resolution,
power, size, cost, etc.). Present the options in a comparison
table.]

\begin{table}[H]
    \centering
    \caption{Available [Subsystem 1] options.}
    \label{tab:subsystem1-options}
    \begin{tabular}{@{} l c c c c @{}}
        \toprule
        \textbf{Component} & \textbf{Criterion A} & \textbf{Criterion B}
            & \textbf{Criterion C} & \textbf{Selected} \\
        \midrule
        Option 1 & & & & \\
        Option 2 & & & & \checkmark \\
        Option 3 & & & & \\
        \bottomrule
    \end{tabular}
\end{table}

[Justify the selected option in one or two paragraphs~\cite{example_ref}.]

\begin{figure}[H]
    \centering
    %\includegraphics[width=0.40\textwidth]{subsystem1_photo}
    \caption{Selected [Subsystem 1] component.}
    \label{fig:subsystem1}
\end{figure}

% ── Subsystem 2 ─────────────────────────────────────────────
\subsection{[Subsystem 2 – e.g. Processing Unit]}
\label{subsec:prelim-processing}

\begin{table}[H]
    \centering
    \caption{Single board computer comparison.}
    \label{tab:sbc-compare}
    \begin{tabular}{@{} l c c c c @{}}
        \toprule
        \textbf{SBC} & \textbf{CPU} & \textbf{RAM} & \textbf{I/O}
            & \textbf{Selected} \\
        \midrule
        Option 1 & & & & \\
        Option 2 & & & & \checkmark \\
        \bottomrule
    \end{tabular}
\end{table}

% ── Subsystem 3 ─────────────────────────────────────────────
\subsection{[Subsystem 3 – e.g. Power Supply]}
\label{subsec:prelim-power}

[Description and justification.]

% ── Subsystem 4 ─────────────────────────────────────────────
\subsection{[Subsystem 4 – e.g. Mechanical Housing]}
\label{subsec:prelim-housing}

[Description and justification with sketch or CAD view if available.]

\section{Preliminary Software Decisions}
\label{sec:prelim-sw}

[Select the operating system, programming language, key libraries,
and communication protocols. Justify each choice briefly.]
