FrissieKris/Eng_DesignProject_GantryCrane_Group-18/Latex_Report/content/C_additional.tex

% ============================================================
%  APPENDIX C – ADDITIONAL TECHNICAL DATA
% ============================================================
\chapter{Additional Technical Data}
\label{app:technical}

[Include supplementary material that is too detailed for the main
body but necessary for completeness or reproducibility. Typical
content includes:]

\begin{itemize}
    \item Full electrical schematics (if too large for Chapter~\ref{ch:detailed})
    \item Complete test data tables
    \item Extended derivations or calculations
    \item Full source-code listings
    \item Manufacturer datasheets (as PDF pages via \texttt{\textbackslash includepdf})
\end{itemize}

% Example: include a full page from an external PDF datasheet
% \includepdf[pages=1, pagecommand={\thispagestyle{fancy}},
%             scale=0.9]{datasheets/component_datasheet.pdf}

% Example: large landscape schematic
% \begin{landscape}
%   \begin{figure}[H]
%       \centering
%       \includegraphics[width=0.95\linewidth]{full_schematic}
%       \caption{Full system schematic.}
%   \end{figure}
% \end{landscape}
