FrissieKris/Eng_DesignProject_GantryCrane_Group-18/MCTR/Juan_Fourie/GearTesting_Checkpoint1/Report/Report/content/00_Introduction.tex

% ============================================================
%  CHAPTER 1 – INTRODUCTION
% ============================================================
\section{Introduction}
\label{sec:introduction}

This report documents the testing of FDM 3D printed gears to determine their suitability in the construction of a gearbox for a gear pulley system.
