FrissieKris/Eng_DesignProject_GantryCrane_Group-18/MCTR/Juan_Fourie/GearTesting_Checkpoint1/Report/Report/content/04_Discussion.tex

\section{Discussion}
\label{sec:discussion}

\par
From the results seen in figure [\ref{ch:loadvssamplenumber}], it can be seen that the maximum load carried by the rig gears before gear or shaft failure of the rig was around 17kg for the second PLA gear test. Both the PLA and PETG gears seen in figure [\ref{im:2printedGears}] had not failed, implying they will be able to withstand even greater loads.

\par
The mounting options for the gears to the shafts will need to be tested as well \cite{youtube_LetsPrint} \cite{textbook_Shigley}. The gears used in the gearbox will also be of a smaller module, and thickness to be adhere to space limitations on the rig.
