FrissieKris/Eng_DesignProject_GantryCrane_Group-18/MCTR/Juan_Fourie/GearTesting_Checkpoint1/Report/Report/content/05_Conclusion.tex

\section{Conclusion}
\label{sec:conclustion}

\par
The gears tested will be able to bear the load necessary if one gear were to be bear all the torque of the entire load. This has been concluded as unlikely and since the gears of the test rig failed, the implication is that the tested gears will be able to withstand even greater loads. The poorly printed gears withstood 16.68Nm of torque while the requirement is only 11Nm The final gears to be used in the gearbox will however also be tested before final implementation to also test whether the gear mounting option chosen is sufficient.
