FrissieKris/Eng_DesignProject_GantryCrane_Group-18/MCTR/Juan_Fourie/Gearbox_Design/Motor_Gearbox_Drum_Calculations.xlsx

Design Main Specifications
Max Load | 30 | kg
Stroke | 1600 | mm
 | 80 | mm/s
Sheet metal
w | 600 | mm
h | 3 | mm
l | 400 | mm
Gear Specs
Parameter | Value | Unit | Comment
Module | 2 | ul
Number_of_Teeth | 30 | ul
Pressure_Angle | 25 | deg
Gear_Height | 15 | mm
Pitch_Circle | 60 | mm
Addendum_Circle | 64 | mm
Root_Circle | 55 | mm
Clearance_Circle | 56 | mm
Base_Circle | 54.37846722 | mm
Reduction Ratio | 44.50589593 |  | `
Per Stage work | 6.671273936
Np | 11 |  |  | (Greater than 10 but less than 100 so two stage needed)
Ng | 250
m | 22.72727273
Drum Specs
Line Speed | 88 | mm/s
Diameter | 50 | mm
Height | 60 | mm
Starting Serving Factor | 1.5
Circumference | 157.0796327 | mm
Loops of Circ fitted | 12
Rope Length in 1 layer | 1884.955592
Rpm | 30.55774907
Torque | 11.03625 | Nm
Rope Specs
Diameter | 5 | mm
Length | 1600 | mm
Wraps | 10.18591636
3-Phase Motor Specs
Power | 0.18 | kW
Speed | 1360 | rpm
Mass | 4.83 | kg
Shaft | 11 | mm
Keyway | 4*16 | mm
Rated Torque | 1.263877489 | Nm
Starting Torque | 3.791632468 | Nm
