FrissieKris/Eng_DesignProject_GantryCrane_Group-18/MCTR/Juan_Fourie/Gearbox_Design/Gear_Parameters.xlsx

Parameter Name | Value
Module | 2
Number_of_Teeth | 30
Pressure_Angle | 20
Pitch_Circle | 60
Addendum_Circle | 64
Root_Circle | 55
Clearance_Circle | 56
Base_Circle | 24.48492371
