FrissieKris/Eng_DesignProject_GantryCrane_Group-18/EngineeringDesign_Group18_Report/content/09_conclusion.tex

% ============================================================
%  CHAPTER 9 – CONCLUSION
% ============================================================
\chapter{Conclusion}
\label{ch:conclusion}

This report has documented the engineering design process for the gantry crane, including the development of a proposed design in response to the project requirements. The work presented establishes a foundation for completing and evaluating the system.

The design must still be validated before it is implemented. Further work should verify the calculations and component selections against the final requirements, assess the structural and operational performance, and test the assembled crane for safe and reliable operation. Any required design changes, verification results and test findings should be incorporated into the next revision of this report.
