FrissieKris/Eng_DesignProject_GantryCrane_Group-18/Latex_Report/content/03_literature.tex

% ============================================================
%  CHAPTER 3 – LITERATURE STUDY
% ============================================================
\chapter{Literature Study}
\label{ch:literature}

\section{Case Studies}
\label{sec:case-studies}

[Review published research relevant to your problem. Group related
work into subsections. Always cite your sources~\cite{example_ref}.]

\subsection{Case Study 1 – [Topic]}

[Discussion of the first body of literature.]

\subsection{Case Study 2 – [Topic]}

[Discussion of the second body of literature.]

\section{Existing Solutions}
\label{sec:existing-solutions}

[Describe and critically evaluate commercial or academic solutions
that already address (partly or fully) the problem. Highlight
limitations that motivate your own design.]

\section{Possible Solutions}
\label{sec:possible-solutions}

[Identify two or three candidate high-level solution strategies.
Evaluate each against the requirements established in
Chapter~\ref{ch:problem} and justify the approach selected for
further development.]

\section{Display Data}
\label{sec:display-data}

[If your literature study surfaces specific data (experimental
results, performance benchmarks, standards) that will inform the
design, present it here with tables or figures as appropriate.]

% Example figure
\begin{figure}[H]
    \centering
    %\includegraphics[width=0.75\textwidth]{example_figure}
    \caption{[Caption describing the figure and its source~\cite{example_ref}].}
    \label{fig:lit-example}
\end{figure}

% Example table
\begin{table}[H]
    \centering
    \caption{[Table title~\cite{example_ref}].}
    \label{tab:lit-example}
    \begin{tabular}{@{} l c c @{}}
        \toprule
        \textbf{Parameter} & \textbf{Option A} & \textbf{Option B} \\
        \midrule
        Criterion 1 & Value & Value \\
        Criterion 2 & Value & Value \\
        \bottomrule
    \end{tabular}
\end{table}
