FrissieKris/Eng_DesignProject_GantryCrane_Group-18/Latex_Report/content/09_conclusion.tex

% ============================================================
%  CHAPTER 9 – CONCLUSION
% ============================================================
\chapter{Conclusion}
\label{ch:conclusion}

[Summarise what was achieved relative to the objectives stated in
Section~\ref{sec:objectives}. Address each objective explicitly.]

\textbf{Objective 1} was [achieved / partially achieved / not achieved]
because \ldots

\textbf{Objective 2} was [achieved / partially achieved / not achieved]
because \ldots

\textbf{Objective 3} was [achieved / partially achieved / not achieved]
because \ldots

[Comment on the overall performance of the system during testing.
Identify limitations encountered and explain their likely causes.]

\section*{Future Work}

[List and briefly describe improvements or extensions recommended
for future iterations of the project. Common examples include:]

\begin{itemize}
    \item [Improvement 1 – e.g. additional sensor integration]
    \item [Improvement 2 – e.g. automated control loop]
    \item [Improvement 3 – e.g. ruggedised enclosure for field use]
\end{itemize}
