FrissieKris/Eng_DesignProject_GantryCrane_Group-18/MCTR/Juan_Fourie/GearTesting_Checkpoint1/Report/Report/main.tex

% ============================================================
%  NWU Faculty of Engineering – Final Year Project Report
%  main.tex  |  Top-level file
%
%  COMPILE:  pdflatex → biber → pdflatex → pdflatex
%            (or simply run:  latexmk -pdf main)
%
%  FOLDER STRUCTURE expected:
%    main.tex
%    NWUStyle.sty
%    NWUBack.png          <- purple NWU banner image
%    img/                 <- all figures go here
%    bib/
%      MyBib.bib          <- your BibTeX references
%    content/
%      00_abstract.tex
%      01_introduction.tex
%      02_problem_analysis.tex
%      03_literature.tex
%      04_concept.tex
%      05_preliminary.tex
%      06_detailed.tex
%      07_implementation.tex
%      08_testing.tex
%      09_conclusion.tex
%      A_ai_usage.tex
%      B_risk_register.tex
%      C_additional.tex
% ============================================================

% ── Document class ──────────────────────────────────────────
\documentclass[12pt, a4paper]{report}

\usepackage{NWUStyle} %You need the NWUStyle.sty file to be able to use this command.
 \usepackage{indentfirst}
% Point biblatex at your .bib file
\addbibresource{bib/MyBib.bib}

%================================================================================

% ============================================================
%    EDIT THESE FIELDS FOR YOUR PROJECT  
% ============================================================
 
% Full project title (appears large on cover)
\Title{Test Strength of 3D Printed Gears for Use in Pulley System Gearbox}
 
% Subtitle / report descriptor (leave blank with {} if unused)
\ReportTitle{Checkpoint 1 Report}
 
% Author
\Initials{J}
\FirstName{Juan}
\Surname{Fourie}
\StudentNumber{50128523}
 
% Supervisor(s) – leave blank with {} if unused
\Supervisor{Prof Henri Marais}
\CoSupervisor{}           % leave {} if none
\AssistantSupervisor{}    % leave {} if none
 
% ORCID – uncomment \showorcidtrue below and fill in number
\ORCID{0000-0000-0000-0000}
%\showorcidtrue            % uncomment to display ORCID on cover
 
% Degree information
\Degree{Bachelor of Engineering}
\Discipline{Mechatronic Engineering}
\Campus{Potchefstroom Campus}
 
% Module / assignment (for coursework reports – leave {} for FYP)
\Module{MCTR327}
\Assignment{Checkpoint 1}
 
% Dates
\Date{19 September 2026}       % generic date field
\SubmissionDate{19 September 2026}
 
% Turnitin score (leave {} to omit the line)
\TurnitinScore{}
 
% ============================================================

\begin{document}

% ── Cover page ──────────────────────────────────────────────
\MakeTitle
 
% ── Abstract + Keywords ─────────────────────────────────────
%\input{content/00_abstract}
 
% ── Table of Contents / List of Figures / List of Tables ────
\MakeTOCandLOFandLOT
 
% ── Declaration of Originality ──────────────────────────────
%\MakeDeclaration
 
% ── Switch to arabic page numbers for the body ──────────────
\cleardoublepage
\pagestyle{fancy}
\pagenumbering{arabic}
\setcounter{page}{1}
 
%================================================================================
%BEGIN TYPING YOUR DOCUMENT - STARTING HERE.-------------------------------------
%================================================================================

%EACH CHAPTER IS TYPED IN A SEPARATE FILE. YOU CAN ADD EACH FILE INTO YOUR DOCUMENT USING THE \input COMMAND.
% MAKE SURE THE FILES ARE IN THE SAME FOLDER AS THIS MAIN FILE.

% \input{content/ExampleChapter1} %Include the contents of the file "ExampleChapter1.tex"
% \input{content/ExampleChapter2} %Include the contents of the file "ExampleChapter2.tex"
% \input{content/ExampleChapter3} %Include the contents of the file "ExampleChapter3.tex"

\input{content/00_Introduction}
\input{content/01_ExperimentalSetup}
\input{content/02_Method}
\input{content/03_Results}
\input{content/04_Discussion}
\input{content/05_Conclusion}

% ── References ──────────────────────────────────────────────
 \newpage
 \printbibliography[heading=bibintoc, title={References}]
 
% ── Appendices ──────────────────────────────────────────────
\newpage
\appendix
\input{content/A_ExcelCalculations}
\input{content/B_Equations}
% \input{content/C_additional}
 
\end{document}
