FrissieKris/Eng_DesignProject_GantryCrane_Group-18/EEII/JP_Smith/Mag_FEMM_Bld.png

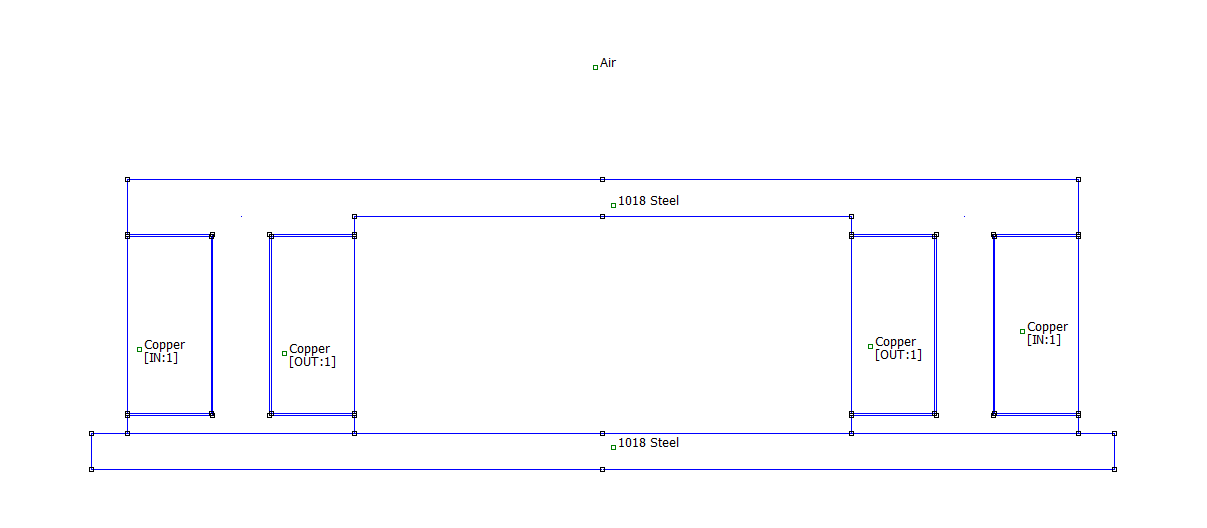
EEII/JP_Smith/Mag_FEMM_Bld.png
