FrissieKris/Eng_DesignProject_GantryCrane_Group-18/EEII/JP_Smith/Plate_ON_Response_Scope.jpeg

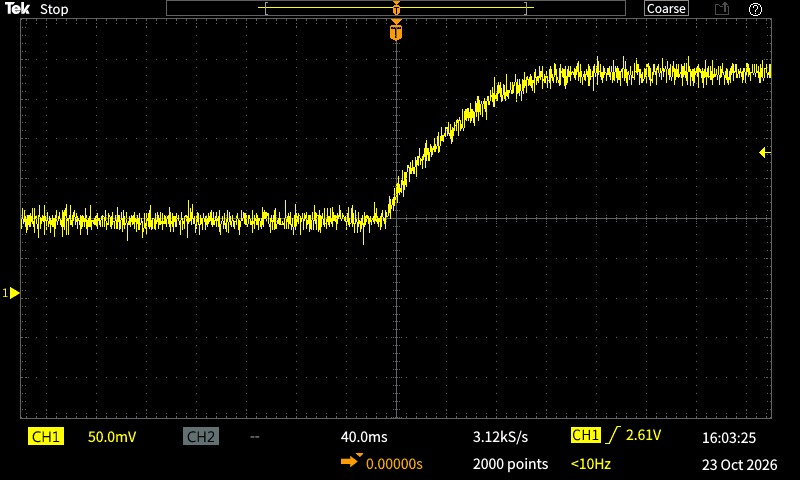
EEII/JP_Smith/Plate_ON_Response_Scope.jpeg
