FrissieKris/Eng_DesignProject_GantryCrane_Group-18/EngineeringDesign_Group18_Report/figures/FEMM.png

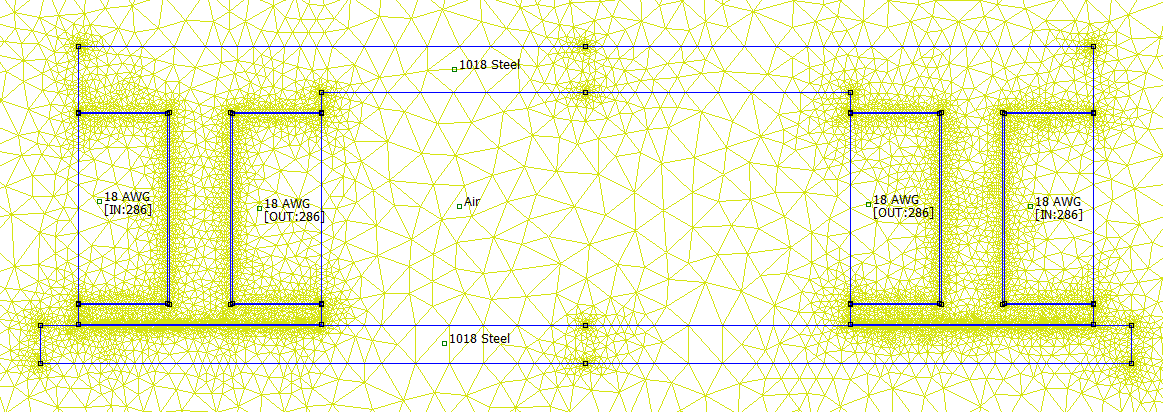
EngineeringDesign_Group18_Report/figures/FEMM.png
