FrissieKris/Eng_DesignProject_GantryCrane_Group-18/EngineeringDesign_Group18_Report/figures/Figure_8_10_Software_Sources.png

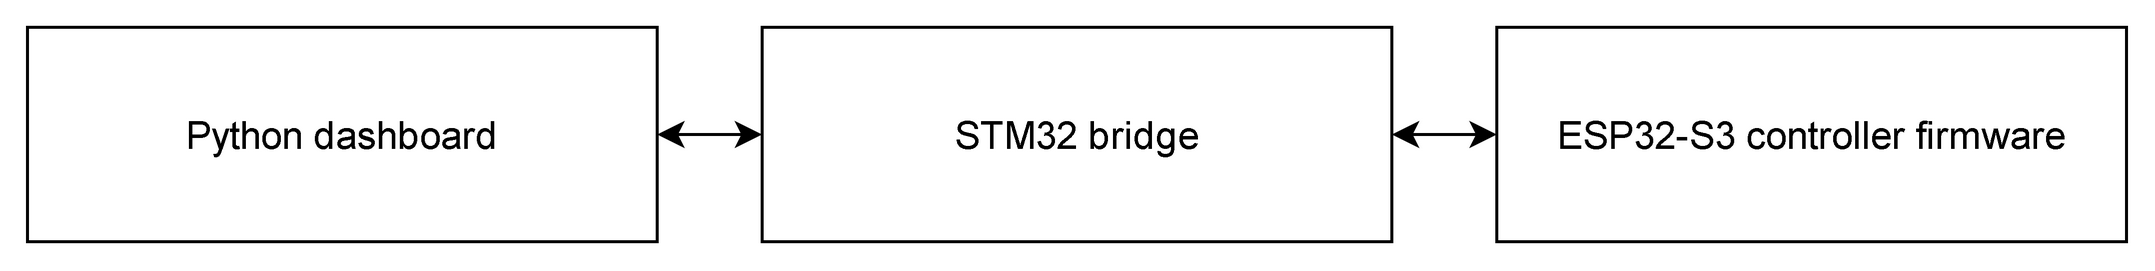
EngineeringDesign_Group18_Report/figures/Figure_8_10_Software_Sources.png
