FrissieKris/Eng_DesignProject_GantryCrane_Group-18/EngineeringDesign_Group18_Report/figures/LifeCycleofGantryCrane_Diagram.png

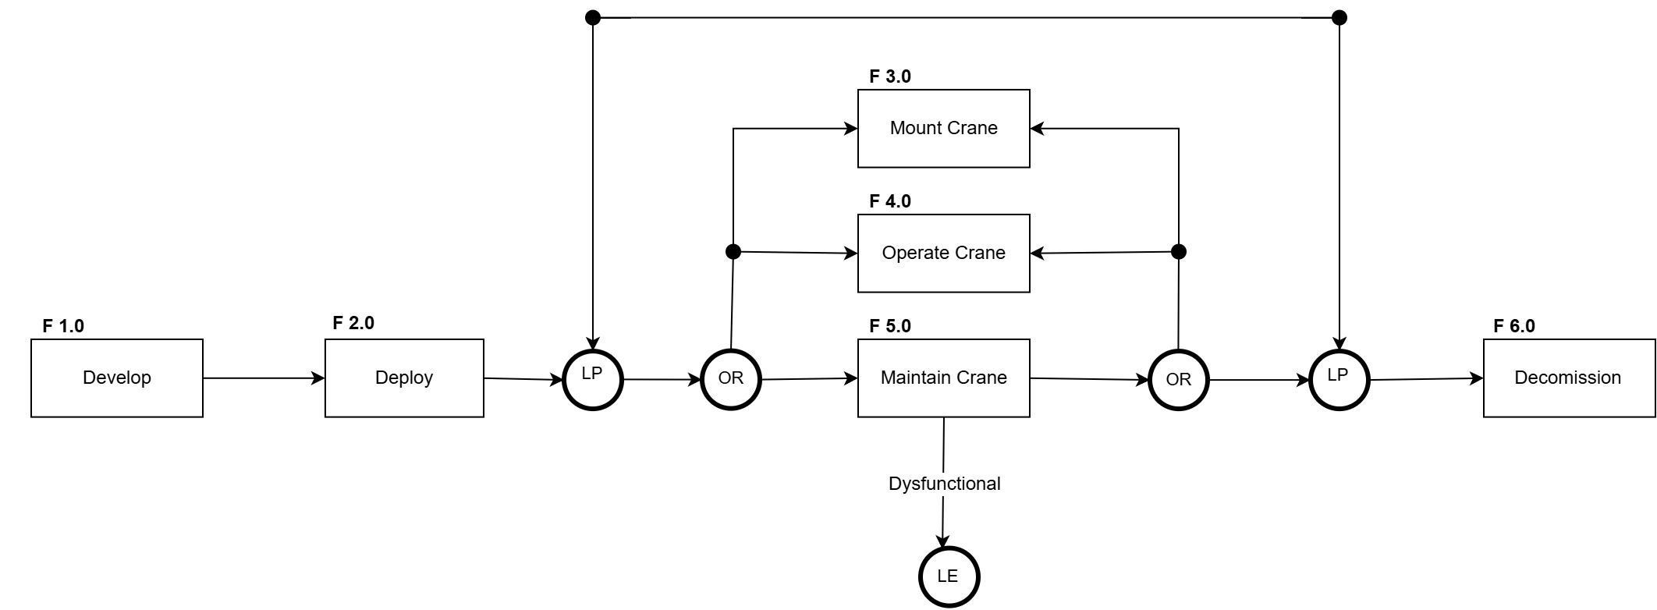
EngineeringDesign_Group18_Report/figures/LifeCycleofGantryCrane_Diagram.png
