FrissieKris/Eng_DesignProject_GantryCrane_Group-18/EngineeringDesign_Group18_Report/figures/REII_Dashboard_Interface.png

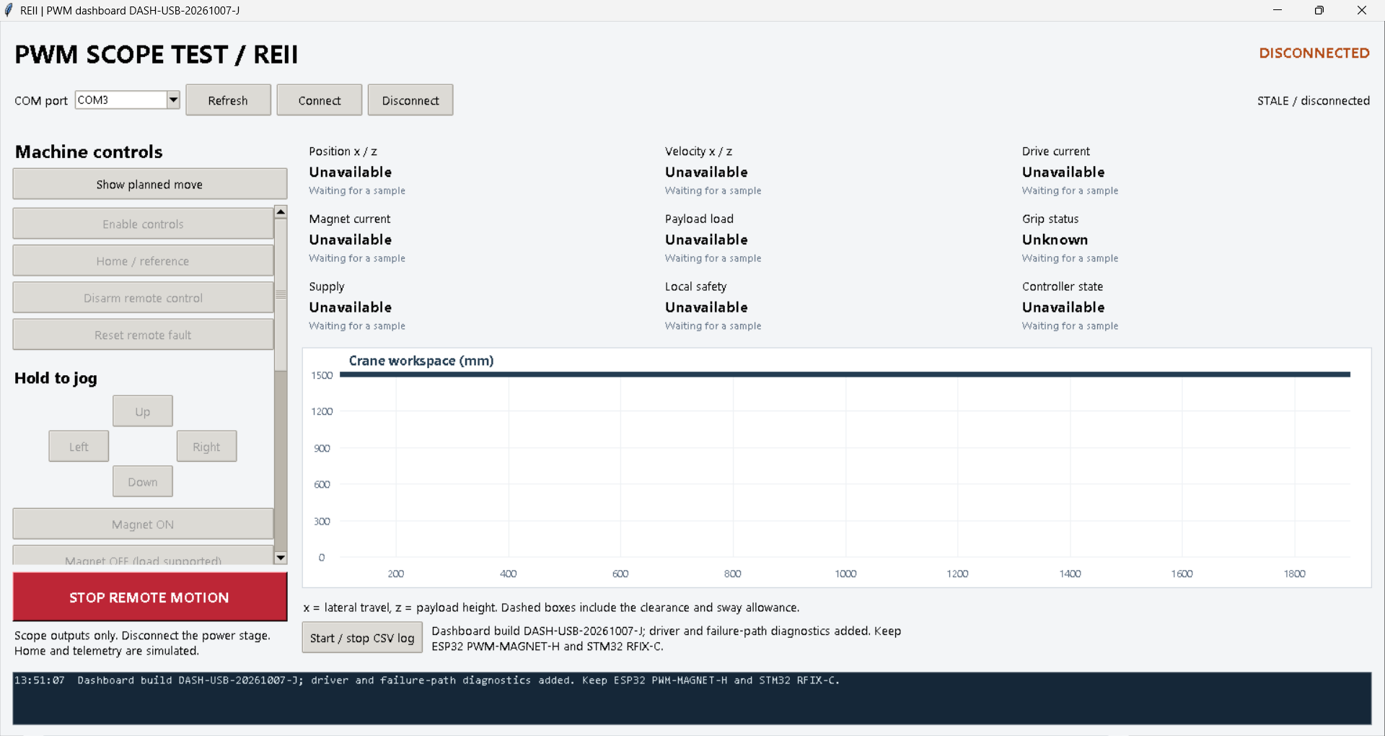
EngineeringDesign_Group18_Report/figures/REII_Dashboard_Interface.png
