FrissieKris/Eng_DesignProject_GantryCrane_Group-18/EngineeringDesign_Group18_Report/figures/REII_STM32_Ground_Station.jpg

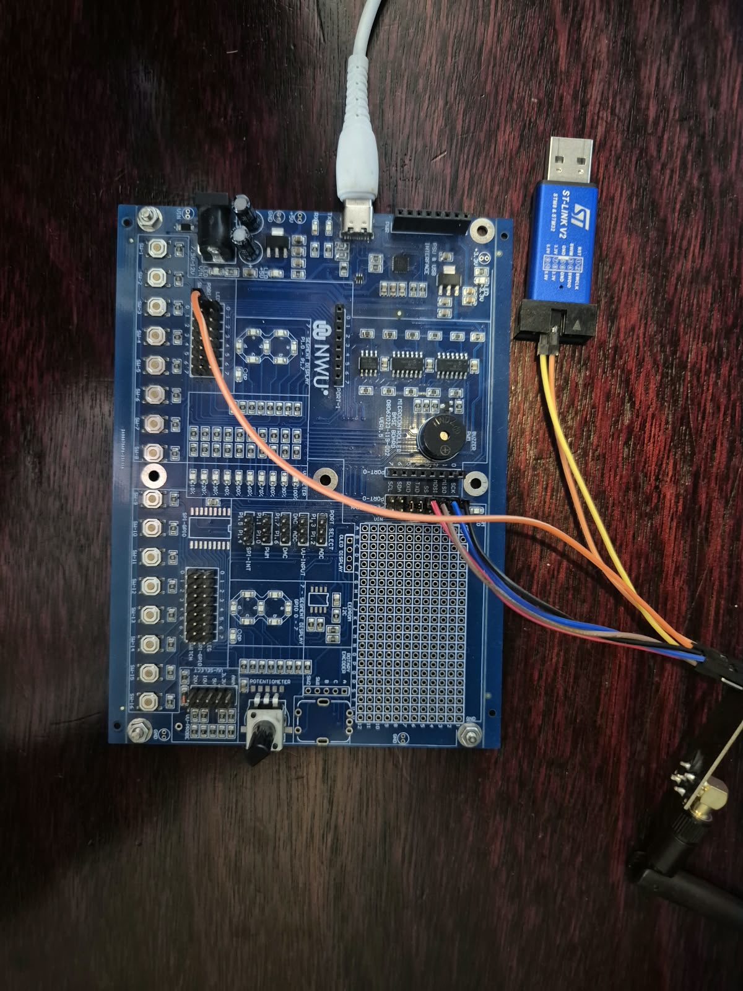
EngineeringDesign_Group18_Report/figures/REII_STM32_Ground_Station.jpg
