FrissieKris/Eng_DesignProject_GantryCrane_Group-18/EngineeringDesign_Group18_Report/img/NWU2.png

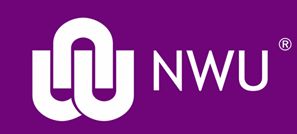
EngineeringDesign_Group18_Report/img/NWU2.png
