FrissieKris/Eng_DesignProject_GantryCrane_Group-18/EngineeringDesign_Group18_Report/img/NWUBack.png

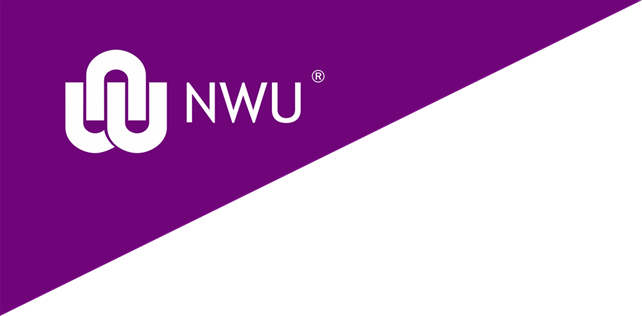
EngineeringDesign_Group18_Report/img/NWUBack.png
