FrissieKris/Eng_DesignProject_GantryCrane_Group-18/Cost_and_Budget.xlsx

EEII I |  |  |  |  |  |  |  |  | Budget Total | Budget Available |  | Status | Ordered | Not Ordered | Delivered
 | Part | Amount | Cost/Unit | Shipping | Order Cost | Link | Description | Status | R 5000.00 | R 3885.19
Total Cost | 0
EEII II
 | Part | Amount | Cost/Unit | Shipping | Order Cost | Link | Description | Status
Total Cost | 0
MCTR I
 | Part | Amount | Cost/Unit | Shipping | Order Cost | Link | Description | Status
Total Cost | 0
MCTR II
 | Part | Amount | Cost/Unit | Shipping | Order Cost | Link | Ordered From | Status
 | Ball Bearings | 8 | 14.53 |  | 116.24 | https://bmgworld.net/product/6000%202RS%20BTC?catCode=bearings | BMG | Ordered | Ordered | Not Ordered | Received
 | Load Cell | 1 | 493.35 | 135.7 | 429 | https://www.robotics.org.za/YZC-516-100KG | Micro Robotics | Ordered
 | HX711 | 1 | 43.7 |  | 179.4 | https://www.robotics.org.za/HX711-MOD?search=hx711 | Micro Robotics
 | Brake Power Supply | 1 | 339.28 |  | 390.17 | https://za.rs-online.com/web/p/switching-power-supplies/1065834 | RS Electronics |  | 4346.71
Total Cost | 1114.81
 | Brake | 1 | 690 | 217.68 | 907.68 | https://www.eastelite.co.za/product/online-shop-parts/drive-motors-replacment-wheels-and-motors/brake-assy-ept15h/ | East Elite | Ordered Personally
REII
 | Part | Amount | Cost/Unit | Shipping | Order Cost | Link | Description | Status
Total Cost | 0
