FrissieKris/Eng_DesignProject_GantryCrane_Group-18/Orders Placed/MicroRobotics/Fourie_50128523_MicroRobotics_OrderDetails.png

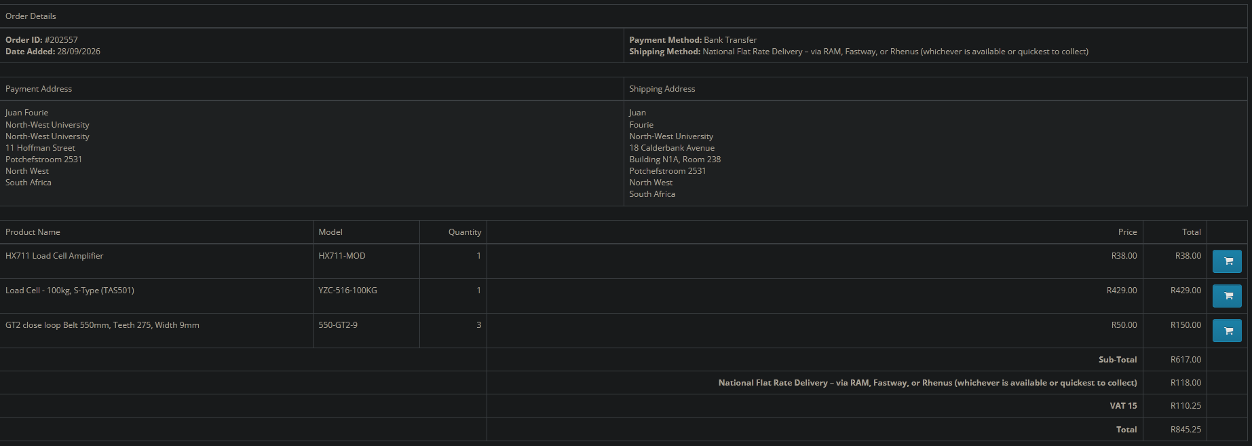
Orders Placed/MicroRobotics/Fourie_50128523_MicroRobotics_OrderDetails.png
