FrissieKris/Eng_DesignProject_GantryCrane_Group-18/MCTR/Juan_Fourie/GearTesting_Checkpoint1/GearAssembly/Assembly1.stp

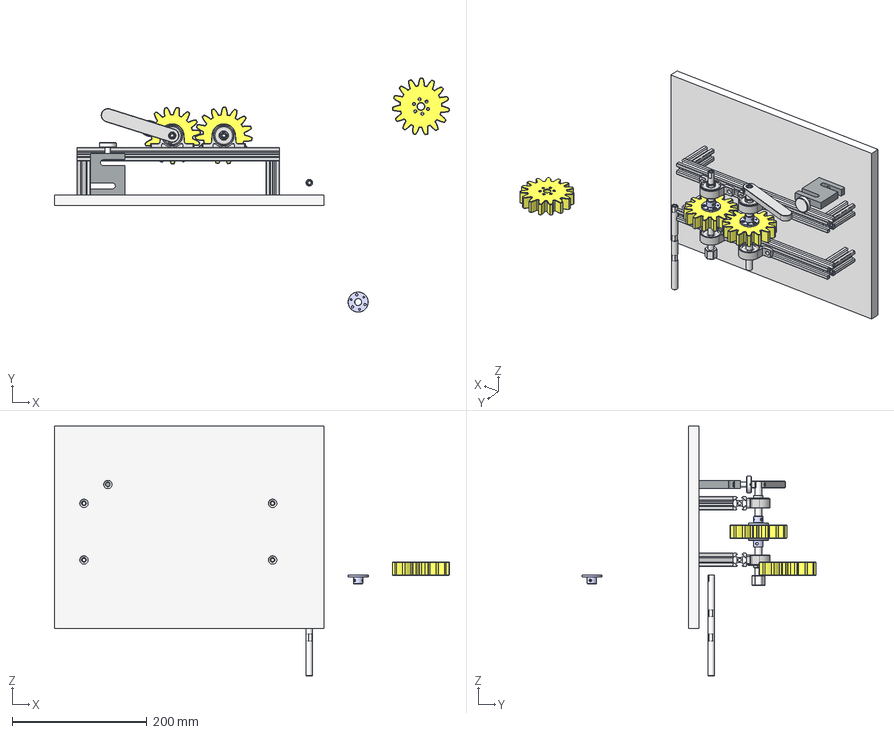
[picture p24: CAD file, 2026-09-07]
MCTR/Juan_Fourie/GearTesting_Checkpoint1/GearAssembly/Assembly1.stp
586.3 x 347.8 x 370.6 mm
Spur Gear Receiver x 3
Mounting Boss x 5
ASME/ANSI B18.3.5M - M3x20(1) x 3
ASME/ANSI B18.3.5M - M3x25(1) x 4
KP000 Pillow block bearing 10mm diameter x 4
ASME/ANSI B18.3.5M - M3x6(1) x 2
Shaft x 3
CellArm
Loadcell
CellInterface
2020 Extrusion x 2
2020 Extrusion Leg x 4
Input Adaptor
IS 2388 - M5 x 8 x 2
Mounting Base
