FrissieKris/Eng_DesignProject_GantryCrane_Group-18/MCTR/Juan_Fourie/3DPrinting/JFourie_50128523_TestGearModule5(2).3mf

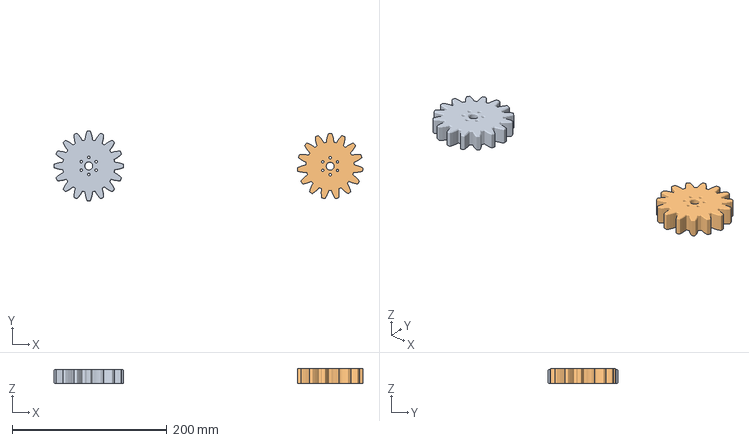
[picture p25: CAD file, 2026-09-19]
MCTR/Juan_Fourie/3DPrinting/JFourie_50128523_TestGearModule5(2).3mf
399.4 x 90.0 x 20.0 mm
JFourie_50128523_TestGearModule5(2).stl
Spur Gear Receiver.stl
