FrissieKris/Eng_DesignProject_GantryCrane_Group-18/MCTR/Juan_Fourie/GearTesting_Checkpoint1/GearAssembly/JFourie_50128523_TestGearModule5PLA.stp

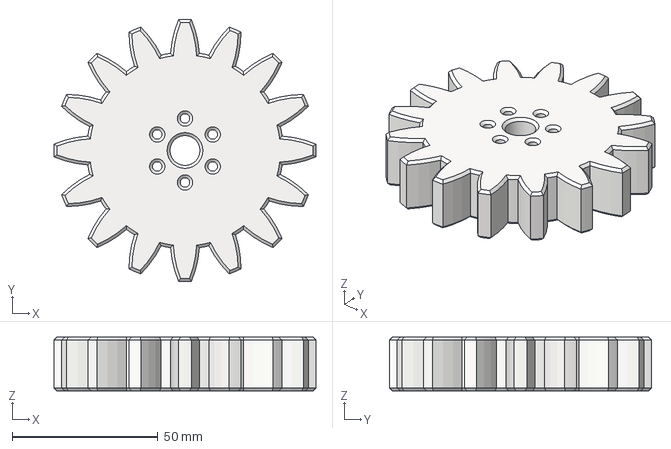
[picture p26: CAD file, 2026-09-07]
MCTR/Juan_Fourie/GearTesting_Checkpoint1/GearAssembly/JFourie_50128523_TestGearModule5PLA.stp
90.0 x 90.0 x 18.5 mm
