FrissieKris/Eng_DesignProject_GantryCrane_Group-18/MCTR/Romeo_Mapasa/gear cornical wheel.stl

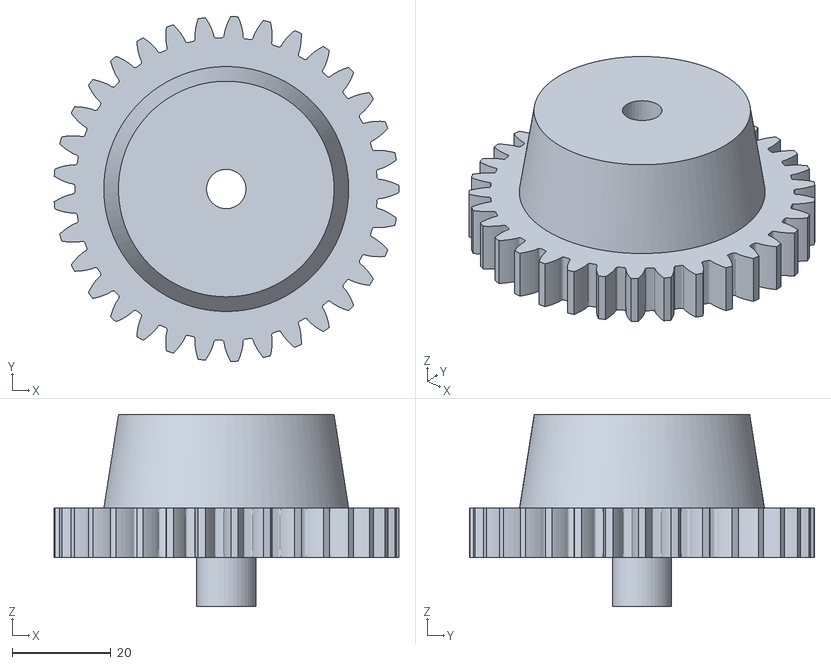
[picture p28: CAD file, 2026-09-19]
MCTR/Romeo_Mapasa/gear cornical wheel.stl
69.9 x 70.0 x 39.0
