FrissieKris/Eng_DesignProject_GantryCrane_Group-18/MCTR/Juan_Fourie/3DPrinting/Spur Gear Receiver.stl

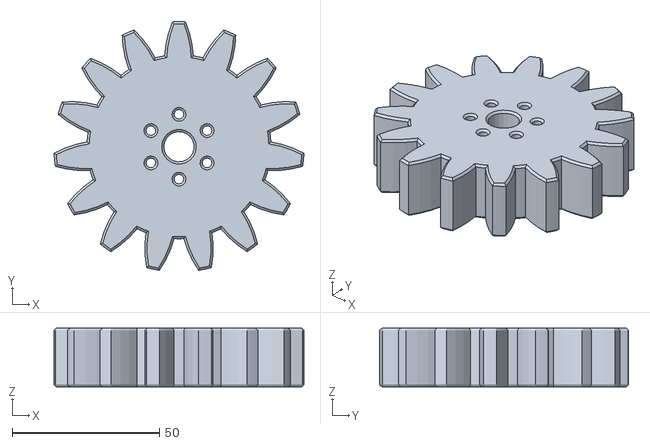
[picture p29: CAD file, 2026-09-19]
MCTR/Juan_Fourie/3DPrinting/Spur Gear Receiver.stl
84.9 x 84.5 x 20.0
