FrissieKris/Eng_DesignProject_GantryCrane_Group-18/MCTR/Romeo_Mapasa/Gear drive.stl

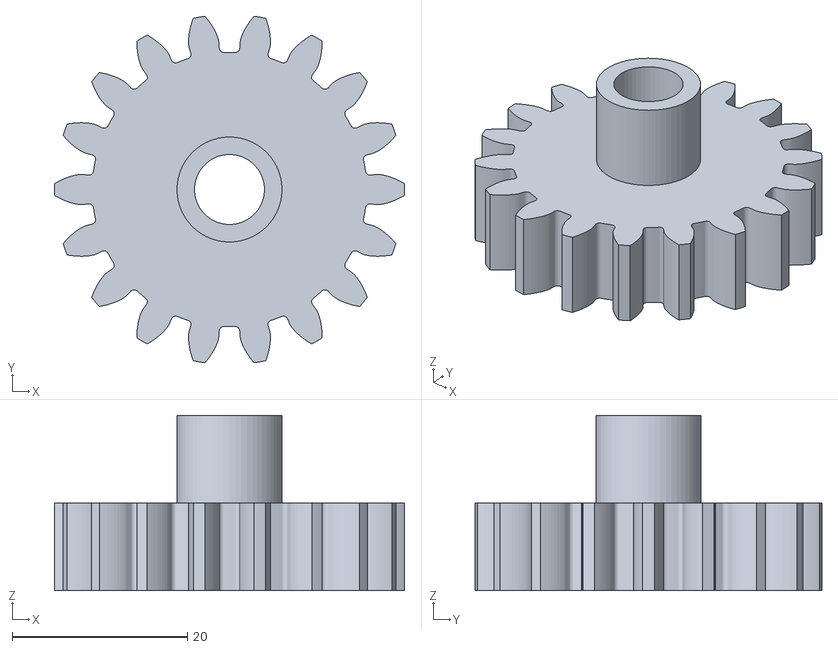
[picture p30: CAD file, 2026-09-19]
MCTR/Romeo_Mapasa/Gear drive.stl
40.0 x 39.6 x 20.0
