FrissieKris/Eng_DesignProject_GantryCrane_Group-18/(list of files, cad)

Other CAD files:
MCTR/Juan_Fourie/3DPrinting/JFourie_50128523_TestGearModule5(2).stl
MCTR/Juan_Fourie/GearTesting_Checkpoint1/GearAssembly/Assembly1.iam
MCTR/Juan_Fourie/GearTesting_Checkpoint1/GearAssembly/Assembly1/Design Accelerator/Spur Gear11.ipt
MCTR/Juan_Fourie/GearTesting_Checkpoint1/GearAssembly/Assembly1/Design Accelerator/Spur Gear21.ipt
MCTR/Juan_Fourie/GearTesting_Checkpoint1/GearAssembly/Assembly1/Design Accelerator/Spur Gears1.iam
MCTR/Juan_Fourie/GearTesting_Checkpoint1/GearAssembly/OldVersions/Assembly1.0001.iam
MCTR/Juan_Fourie/GearTesting_Checkpoint1/GearAssembly/OldVersions/Test_SpurGear_Module5_Teeth16_Shaft10.0001.ipt
MCTR/Juan_Fourie/GearTesting_Checkpoint1/GearAssembly/OldVersions/Test_SpurGear_Module5_Teeth16_Shaft10_RigData.0001.ipt
MCTR/Juan_Fourie/GearTesting_Checkpoint1/GearAssembly/Test_SpurGear_Module5_Teeth16_Shaft10.ipt
MCTR/Juan_Fourie/GearTesting_Checkpoint1/GearAssembly/Test_SpurGear_Module5_Teeth16_Shaft10_RigData.ipt
MCTR/Juan_Fourie/GearTesting_Checkpoint1/GearTestRig/TestRig/2020 Extrusion Leg.ipt
MCTR/Juan_Fourie/GearTesting_Checkpoint1/GearTestRig/TestRig/2020 Extrusion.ipt
MCTR/Juan_Fourie/GearTesting_Checkpoint1/GearTestRig/TestRig/ASME_ANSI B18.3.5M - M3x20(1).ipt
MCTR/Juan_Fourie/GearTesting_Checkpoint1/GearTestRig/TestRig/ASME_ANSI B18.3.5M - M3x25(1).ipt
MCTR/Juan_Fourie/GearTesting_Checkpoint1/GearTestRig/TestRig/ASME_ANSI B18.3.5M - M3x6(1).ipt
MCTR/Juan_Fourie/GearTesting_Checkpoint1/GearTestRig/TestRig/CellArm.ipt
MCTR/Juan_Fourie/GearTesting_Checkpoint1/GearTestRig/TestRig/CellInterface.ipt
MCTR/Juan_Fourie/GearTesting_Checkpoint1/GearTestRig/TestRig/IS 2388 - M5 x 8A.ipt
MCTR/Juan_Fourie/GearTesting_Checkpoint1/GearTestRig/TestRig/Input Adaptor.ipt
MCTR/Juan_Fourie/GearTesting_Checkpoint1/GearTestRig/TestRig/KP000 Pillow block bearing 10mm di.ipt
MCTR/Juan_Fourie/GearTesting_Checkpoint1/GearTestRig/TestRig/Loadcell.ipt
MCTR/Juan_Fourie/GearTesting_Checkpoint1/GearTestRig/TestRig/Mounting Base.ipt
MCTR/Juan_Fourie/GearTesting_Checkpoint1/GearTestRig/TestRig/Mounting Boss.ipt
MCTR/Juan_Fourie/GearTesting_Checkpoint1/GearTestRig/TestRig/Shaft.ipt
MCTR/Juan_Fourie/GearTesting_Checkpoint1/GearTestRig/TestRig/Spur Gear Receiver.ipt
MCTR/Juan_Fourie/GearTesting_Checkpoint1/GearTestRig/TestRig/TestRig.iam
MCTR/Juan_Fourie/Gearbox_Design/Gear_Template.ipt
MCTR/Juan_Fourie/Gearbox_Design/Pulley_Gearbox.ipt
MCTR/Juan_Fourie/OldVersions/GearTrain_Assembly.0001.iam
MCTR/Juan_Fourie/OldVersions/Gears.0008.ipt
