FrissieKris/Eng_DesignProject_GantryCrane_Group-18/Latex_Report/content/A_ai_usage.tex

% ============================================================
%  APPENDIX A – GENERATIVE AI USAGE LOG
% ============================================================
\chapter{Generative AI Usage}
\label{app:ai-usage}

[List every instance where generative AI tools were used to assist
in writing or editing any part of this report, as required by the
Declaration of Originality.]

\begin{table}[H]
    \centering
    \caption{Generative AI (GA) evidence throughout the report.}
    \label{tab:ga-evidence}
    \begin{tabular}{@{} l l p{3.5cm} p{4.5cm} @{}}
        \toprule
        \textbf{Section} & \textbf{Tool} & \textbf{Prompt summary}
            & \textbf{How output was used} \\
        \midrule
        \S\ref{sec:sw-impl} & ChatGPT-4o
            & ``Explain threading model for \ldots''
            & Edited, verified, and rewritten in own words. \\
        \bottomrule
    \end{tabular}
\end{table}
