FrissieKris/Eng_DesignProject_GantryCrane_Group-18/EngineeringDesign_Group18_Report/content/06_test_plans.tex

% ============================================================
%  CHAPTER 6 – TEST PLAN
% ============================================================
\chapter{Test Plan}
\label{ch:test-plan}
This chapter discusses the individual subsystem verification test plans (Section~\ref{sec:individual-tests}), subsystem integration testing (Section~\ref{sec:integration-tests}), and full-system validation (Section~\ref{sec:system-validation}) to be implemented to ensure the functioning of each subsystem as a whole. The persons responsible for collaboration on the test plan are the 2 persons who have the role in the subsection title. Testing is divided into individual subsystem verification,
subsystem integration testing, and full-system validation.

Each test shall specify the initial conditions, test procedure,
expected result, and acceptance criteria. The actual result and
test status shall be recorded during execution.

\section{Test Procedure and Acceptance Criteria}
The following information shall be documented for each test:
\begin{itemize}
    \item \textbf{Test ID:} A unique identifier for the test.
    \item \textbf{Objective:} The functionality or requirement
    being verified.
    \item \textbf{Initial conditions:} The required system
    configuration before testing.
    \item \textbf{Procedure:} The steps followed to perform the test.
    \item \textbf{Expected result:} The anticipated system response.
    \item \textbf{Acceptance criteria:} The measurable conditions
    required for the test to pass.
    \item \textbf{Actual result:} The observed outcome.
    \item \textbf{Status:} Pass, Fail, or Not Tested.
\end{itemize}

\section{Individual Test Plans}
\label{sec:individual-tests}

Each subsystem shall first be tested independently, where
practical, to establish that its functionality meets the
specified design requirements before integration testing.

\subsection{EERI I}
\label{subsec:eeri-i-tests}

\textbf{Subsystem function:} Convert the single-phase 230VAC to DC and generate a controlled three-phase output for the
induction motor. The subsystem must also provide isolated swithcing control, current feedback to REII and hardware
protection against shoot through and overcurrent conditions.

\textbf{Test setup:} Complete drive-electronics assembly consisting of the rectifier, DC-link stage, three-phase IGBT 
inverter, IR2104 gate drivers, isolation circuitry and current-sensing/protection circuit. Initial switching tests shall
be performed using a current-limited low-voltage DC supply and resistive or RL test load before any high-voltage 
testing is attempted. Required equipment includes a function generator or controller PWM source, oscilloscope, 
differential probe where required, multimeter, current-limited bench supply and suitable test loads. High-voltage 
DC-bus and mains tests shall only be performed using the required electrical protection and under appropriate 
laboratory supervision.

\begin{table}[htbp]
    \centering
    \caption{EERI I test plan}
    \label{tab:eeri-i-tests}

    \renewcommand{\arraystretch}{1.2}
    \footnotesize

    \begin{tabularx}{\textwidth}{|l|X|X|X|l|}
        \hline
        \textbf{ID} &
        \textbf{Test} &
        \textbf{Procedure} &
        \textbf{Expected result} &
        \textbf{Status} \\
        \hline

        EI-01 &
        Half-bridge switching &
        Apply 50\% PWM to one inverter leg using a low-voltage DC bus. Measure gate and output voltages. &
        IGBTs switch correctly and the output follows the PWM signal. &
        NT \\
        \hline

        EI-02 &
        Three-phase output &
        Apply three phase-shifted PWM signals and measure the inverter outputs. &
        Balanced outputs with approximately 120$^\circ$ phase displacement. &
        NT \\
        \hline

        EI-03 &
        Dead time &
        Measure high- and low-side gate signals of each inverter leg. &
        No simultaneous conduction; dead time is at least 400 ns. &
        NT \\
        \hline

        EI-04 &
        Overcurrent protection &
        Apply a controlled overload until the protection threshold is exceeded. &
        Gate signals are disabled when the trip threshold is exceeded. &
        NT \\
        \hline

        EI-05 &
        Current feedback &
        Apply known currents to the ACS72981 and measure its controller output. &
        Output follows current and remains below 2.048 V. &
        NT \\
        \hline

        EI-06 &
        Rectifier and DC bus &
        Apply AC to the rectifier/DC-link stage and measure the DC-bus voltage. &
        Correct polarity and stable DC output are obtained. &
        NT \\
        \hline

        EI-07 &
        Emergency shutdown &
        Operate the drive and activate the hardware emergency stop. &
        HV supply is disconnected and inverter switching stops. &
        NT \\
        \hline

    \end{tabularx}
\end{table}

\subsection{EERI II}
\label{subsec:eeri-ii-tests}

\textbf{Subsystem function:}
The EERI II subsystem provides magnetic attachment for up to 20\,kg of steel plate (FR10),
on-load status through current sensing (FR11),
solid-state switching with flyback protection,
and thermal stability.

\textbf{Test setup:}
Tests are conducted using a 22\,kg steel test plate (from the scrapyard), a digital oscilloscope, an ACS712-30A current sensor,
a variable DC power supply,
and a thermal camera.

\begin{table}[htbp]
    \centering
    \small
    \caption{EERI II test plan.}
    \label{tab:eeri-ii-tests}
    \renewcommand{\arraystretch}{1.15}
    \begin{tabularx}{\textwidth}{|l|X|X|X|X|}
        \hline
        \textbf{Test ID} &
        \textbf{Test description} &
        \textbf{Procedure} &
        \textbf{Expected result} &
        \textbf{Status} \\
        \hline
        EII-01 & Static holding capacity &
        Place the 22\,kg steel test plate against the 3 U-cores. Energise coils at $13.5\,\text{V}$.
        Pick up the magnet and see if it holds. &
        By desighn it will hold a 22\,kg steel plate, verifying a safety factor at least 1.1&
        Pass, see Fig.~\ref{fig:eeri2-magnet-lift} \\
        \hline
        EII-02 & On-load current transient test (FR11, IR2) &
        Connect oscilloscope to ACS712, and connect magnets to DC power supply. Turn on unloaded and loaded.
        Measure rise time constant $\tau$ and verify $V_{\mathrm{ISENSE}} \le 2.048\,\text{V}$. &
        Unloaded time constant $\tau_{\mathrm{off}} \approx 31.1\,\text{ms}$, and loaded time constant $\tau_{\mathrm{on}} \approx 88.2\,\text{ms}$. Sense voltage remains below $2.048\,\text{V}$. &
        Pass, see Fig.~\ref{fig:eeri2-magnet-response} \\
        \hline
        EII-03 & Thermal stability while on. &
        place one core on thw plate and point a thermal camera at it. Turn on the magnet in still air at and at 4.5\,V.
        Record temperature and current every 30 seconds for 16 minutes. &
        Surface temperature stabilizes at $\le 40^\circ\text{C}$, well below the limit of the insulation.
        Current drop due the copper heating up, but still remains above 2.5\,A. &
        Pass, see Fig.~\ref{fig:eeri2-magnet-temp} \\
        \hline
        EII-04 & Inductive flyback test (FR8) &
        Connect a $10\times$ oscilloscope probe across the IRF540Z drain and source.
        Energise coils and turn off again. Capture peak drain to source voltage and demagnetisation duration. &
        The MBR1060 Schottky diode will clamp flyback voltage to $\le 15.0\,\text{V}$, witch is below the $100\,\text{V}$ MOSFET rating. &
        To be completed. \\
        \hline
    \end{tabularx}
\end{table}

\begin{figure}[H]
    \centering
    
    \caption{Magnets lifting 22Kg test plate.}
    \label{fig:eeri2-magnet-lift}
\end{figure}

\begin{figure}[H]
    \centering
    
    \caption{Magnets response to a step input.}
    \label{fig:eeri2-magnet-response}
\end{figure}

\begin{figure}[H]
    \centering
    
    \caption{Magnets temperature and current over 16 minutes.}
    \label{fig:eeri2-magnet-temp}
\end{figure}

\subsection{MCTR I}
\label{subsec:mctr-i-tests}

\textbf{Subsystem function:} [Insert the function of MCTR I.]

\textbf{Test setup:} [Insert the required equipment, configuration,
and initial conditions.]

\begin{table}[htbp]
    \centering
    \caption{MCTR I test plan}
    \label{tab:mctr-i-tests}
    \renewcommand{\arraystretch}{1.4}
    \begin{tabularx}{\textwidth}{|l|X|X|X|X|}
        \hline
        \textbf{Test ID} &
        \textbf{Test description} &
        \textbf{Procedure} &
        \textbf{Expected result} &
        \textbf{Status} \\
        \hline
        MCI-01 & [Functional test] &
        [Test procedure] &
        [Expected behaviour] &
        [Pass/Fail/NT] \\
        \hline
        MCI-02 & [Performance test] &
        [Test procedure] &
        [Acceptance criterion] &
        [Pass/Fail/NT] \\
        \hline
        MCI-03 & [Safety or fault test] &
        [Test procedure] &
        [Expected safe response] &
        [Pass/Fail/NT] \\
        \hline
    \end{tabularx}
\end{table}

\subsection{MCTR II}
\label{subsec:mctr-ii-tests}
\input{content/0p0_mctr2_parameters}

\textbf{Subsystem function:} Raise and lower a payload of up to \InMassRated\,kg through
a \InStroke\,m stroke on a rope and drum, hold it without drift when power or command is
lost, and report the on-hook load to the controller (FR4, FR5, FR6, PT2).
 
\textbf{Test setup:} Complete hoist assembly (motor, coupling, gearbox, brake, drum, rope,
load cell with sheave, HX711) bolted to the test frame; VSD or bench supply for the motor;
48\,V brake supply and relay; controller or bench read-out of the HX711; calibrated
reference masses (5, 10, 20, 30\,kg); stopwatch or encoder for timing; tape measure for drift.
Protect the area below the load. The 30\,kg proof test is performed last.
 
\begin{table}[htbp]
    \centering
    \caption{MCTR II test plan}
    \label{tab:mctr-ii-tests}
    \small
    \renewcommand{\arraystretch}{1.4}
    \begin{tabularx}{\textwidth}{|l|X|X|X|X|}
        \hline
        \textbf{Test ID} &
        \textbf{Test description} &
        \textbf{Procedure} &
        \textbf{Expected result} &
        \textbf{Status} \\
        \hline
        MCII-01 & Functional: raise and lower (FR4) &
        Command raise then lower with \InMassRated\,kg over the full stroke. &
        Moves in the commanded direction over the full \InStroke\,m without slip or rope overlap. &
        [Pass/Fail/NT] \\
        \hline
        MCII-02 & Performance: hoist rate (PT2) &
        Time a full-stroke raise with \InMassRated\,kg at the VSD frequency available. &
        Stroke time $\le \InTimeReq$\,s; predicted \showv{Tstroke}{1}{s} at \InVsdF\,Hz. &
        [Pass/Fail/NT] \\
        \hline
        MCII-03 & Safety: fail-safe brake (FR6) &
        Hold \InMassRated\,kg mid-stroke, remove brake power, then remove command signal. &
        Brake engages; drift $\le$ \tbd{mm} in \tbd{min}. &
        [Pass/Fail/NT] \\
        \hline
        MCII-04 & Functional: load feedback (FR5) &
        Hang 0, 5, 10, 20, 30\,kg and record the HX711 reading; fit a two-point calibration. &
        Reading within \tbd{\%} of the reference mass over the range; resolution about \showv{ResG}{0}{g}. &
        [Pass/Fail/NT] \\
        \hline
        MCII-05 & Safety: overload interlock &
        Raise a mass above the trip level of \showv{Mtrip}{1}{kg}. &
        Raising stops and the brake engages within \showv{Latency}{0}{ms}. &
        [Pass/Fail/NT] \\
        \hline
        MCII-06 & Performance: structural proof &
        Hold \InMassDesign\,kg statically for 60\,s on the rig. &
        No visible deformation or tooth damage; shaft safety factor $\ge$ \InSFreq\ in Appendix~\ref{app:technical}. &
        [Pass/Fail/NT] \\
        \hline
        MCII-07 & Performance: gear test pair &
        Load a printed stage~B pair in the rig through a torque arm to failure. &
        Failure torque gives the measured allowable stress replacing \InSigAllow\,MPa. &
        [Pass/Fail/NT] \\
        \hline
    \end{tabularx}
\end{table}

\clearpage
\subsection{REII}
\label{subsec:reii-tests}

\textbf{Subsystem function:}
Transfer motion, hoist and magnet commands; display
position, speed, load, current, fault and grip status;
and perform local signal generation, sensor acquisition
and interlock checks independently of dashboard
communication (FR12--FR14).
\cite{nwu_sysrs2026,nwu_reii_scope2026}

\textbf{Test setup:}
PC with Python dashboard; UART-connected STM32;
two nRF24 radios; ESP32-S3 course board; regulated
supplies; known sensor/status inputs; and an oscilloscope
or logic analyser. Start disarmed with actuator power
stages disconnected. Record commands, replies and timing.
Agree outstanding acceptance limits before testing.
NT means Not Tested.

\begin{table}[H]
    \centering
    \footnotesize
    \caption{REII test plan before integration.}
    \label{tab:reii-tests}
    \renewcommand{\arraystretch}{1.15}
    \setlength{\tabcolsep}{4pt}

    \begin{tabularx}{\textwidth}{|
        >{\raggedright\arraybackslash}p{1.2cm}|
        >{\raggedright\arraybackslash}p{1.9cm}|
        >{\raggedright\arraybackslash}X|
        >{\raggedright\arraybackslash}X|
        >{\centering\arraybackslash}p{1.2cm}|
    }
        \hline
        \textbf{Test ID} &
        \textbf{Test description} &
        \textbf{Procedure} &
        \textbf{Expected result} &
        \textbf{Status} \\
        \hline

        RE-01 &
        Inputs and commands &
        Apply known sensor/status inputs, including a fault
        condition. Confirm the lateral reference and test
        arm, disarm, lateral/hoist jog, stop and magnet
        commands. &
        Displayed values and replies match the inputs and
        commands. An unconfirmed reference blocks arming;
        faults and disarm inhibit motion. Stop cancels
        movement. Agreed command interlocks are enforced. &
        NT \\
        \hline

        RE-02 &
        Radio communication &
        Test across the intended operating area with nearby
        radios active. Record sent/received packets,
        retries and reply times. &
        Received replies match their requests. Packet loss
        and reply times meet the limits agreed before
        testing. &
        NT \\
        \hline

        RE-03 &
        Output signals &
        Confirm the reference, arm and issue drive and
        magnet commands. Measure outputs with power
        stages disconnected. &
        Output order, frequency, duty, direction, dead time
        where applicable, and disabled states match the
        agreed driver specifications. &
        NT \\
        \hline

        RE-04 &
        Link loss and recovery &
        Arm and jog, then test button release and interrupted
        communication. Apply known sensor/fault inputs
        during the interruption. Reconnect and record
        outputs and controller state. &
        Verify the proposed 200~ms jog-command expiry and
        500~ms communication timeout. Contact loss stops
        motion and disarms. Local sensing and interlocks
        remain active. Record motion-output disable delay;
        reconnection causes no automatic restart. &
        NT \\
        \hline

        RE-05 &
        Motion planning &
        Generate and simulate lateral anti-sway profiles
        and a path around a known obstacle. Compare
        results with the motion model. &
        Simulated responses meet the agreed model
        tolerances and the path maintains the agreed
        obstacle clearance. Record model inputs and
        results. &
        NT \\
        \hline
    \end{tabularx}
\end{table}

\section{Subsystem Interface Analysis}
\label{sec:interface-analysis}

The subsystem interface analysis identifies the direct interactions
between subsystems. These interfaces may involve mechanical loads,
electrical power, control signals, communication, or physical
connections, as applicable to the design.

\begin{table}[htbp]
    \centering
    \caption{Subsystem interface matrix}
    \label{tab:interface-matrix}
    \renewcommand{\arraystretch}{1.4}
    \begin{tabularx}{\textwidth}{|X|c|c|c|c|c|}
        \hline
        \textbf{Subsystem} &
        \textbf{EERI I} &
        \textbf{EERI II} &
        \textbf{MCTR I} &
        \textbf{MCTR II} &
        \textbf{REII} \\
        \hline
        EERI I   & -- & [X] & [X] & [X] & [X] \\
        \hline
        EERI II  & [X] & -- & [X] & [X] & [X] \\
        \hline
        MCTR I   & [X] & [X] & -- & [X] & [X] \\
        \hline
        MCTR II  & [X] & [X] & [X] & -- & [X] \\
        \hline
        REII     & [X] & [X] & [X] & [X] & -- \\
        \hline
    \end{tabularx}
\end{table}

In Table~\ref{tab:interface-matrix}, replace \texttt{[X]} with
\texttt{X} where a direct interface exists and leave the cell
blank where no direct interface exists. The matrix shall be
used to determine the required integration tests.

\section{Subsystem Integration Test Plan}
\label{sec:integration-tests}

Integration testing verifies that connected subsystems operate
together correctly and that their interfaces satisfy the design
requirements. Testing shall be performed after the relevant
individual subsystem tests have been completed.

\begin{table}[htbp]
    \centering
    \caption{Subsystem integration test plan}
    \label{tab:integration-tests}
    \renewcommand{\arraystretch}{1.4}
    \begin{tabularx}{\textwidth}{|l|X|X|X|X|}
        \hline
        \textbf{Test ID} &
        \textbf{Subsystems} &
        \textbf{Test objective} &
        \textbf{Expected result} &
        \textbf{Status} \\
        \hline
        INT-01 & [Subsystem A and B] &
        Verify the interface between the subsystems &
        [Specified interface behaviour] &
        [Pass/Fail/NT] \\
        \hline
        INT-02 & [Subsystem A and C] &
        Verify coordinated operation &
        [Specified response] &
        [Pass/Fail/NT] \\
        \hline
        INT-03 & [Subsystem B and D] &
        Verify signal, load, or power transfer, as applicable &
        [Specified transfer behaviour] &
        [Pass/Fail/NT] \\
        \hline
        INT-04 & [Relevant subsystems] &
        Verify a multi-subsystem operating sequence &
        [Specified sequence completed correctly] &
        [Pass/Fail/NT] \\
        \hline
        INT-05 & [Relevant subsystems] &
        Verify fault propagation and safe response &
        [Specified fault-handling behaviour] &
        [Pass/Fail/NT] \\
        \hline
    \end{tabularx}
\end{table}

For each integration test, record the initial conditions, test
procedure, measured or observed results, and applicable
acceptance criteria. Tests shall cover every required interface
identified in Table~\ref{tab:interface-matrix}.

\section{Full-System Validation}
\label{sec:system-validation}

Full-system validation shall be conducted after the individual
subsystem and integration tests have been completed. The purpose
is to determine whether the complete gantry crane system satisfies
its overall functional, performance, and safety requirements.

\begin{table}[htbp]
    \centering
    \caption{Full-system validation plan}
    \label{tab:system-validation}
    \renewcommand{\arraystretch}{1.4}
    \begin{tabularx}{\textwidth}{|l|X|X|X|}
        \hline
        \textbf{Test ID} &
        \textbf{Test scenario} &
        \textbf{Acceptance criteria} &
        \textbf{Status} \\
        \hline
        SYS-01 & Normal startup and shutdown &
        [System starts and stops as specified] &
        [Pass/Fail/NT] \\
        \hline
        SYS-02 & Complete operating cycle &
        [Required sequence is completed] &
        [Pass/Fail/NT] \\
        \hline
        SYS-03 & Operation under specified load &
        [Performance remains within limits] &
        [Pass/Fail/NT] \\
        \hline
        SYS-04 & Fault handling and emergency stop &
        [Required safe response is achieved] &
        [Pass/Fail/NT] \\
        \hline
        SYS-05 & Repeated operation &
        [Required repeatability or reliability criteria] &
        [Pass/Fail/NT] \\
        \hline
    \end{tabularx}
\end{table}

\section{Test Results Summary}
\label{sec:test-results-summary}

The results of the subsystem, integration, and full-system tests
shall be consolidated to assess overall system readiness.

\begin{table}[htbp]
    \centering
    \caption{Summary of test outcomes}
    \label{tab:test-summary}
    \renewcommand{\arraystretch}{1.4}
    \begin{tabularx}{\textwidth}{|X|c|c|c|c|}
        \hline
        \textbf{Test category} &
        \textbf{Passed} &
        \textbf{Failed} &
        \textbf{Not tested} &
        \textbf{Total} \\
        \hline
        Individual subsystem tests & [\,] & [\,] & [\,] & [\,] \\
        \hline
        Integration tests & [\,] & [\,] & [\,] & [\,] \\
        \hline
        Full-system validation & [\,] & [\,] & [\,] & [\,] \\
        \hline
        \textbf{Total} & [\,] & [\,] & [\,] & [\,] \\
        \hline
    \end{tabularx}
\end{table}

Any failed or incomplete tests shall be documented together with
the observed behaviour, likely cause, corrective action, and
retesting requirements. The system shall only be declared to have
passed validation when the applicable acceptance criteria have
been met.
