FrissieKris/Eng_DesignProject_GantryCrane_Group-18/MCTR/Juan_Fourie/GearTesting_Checkpoint1/GearTestRig/GearTester_v1/logs/Sample_20260907_082820.csv

sample_no | elapsed_s | timestamp | load_kg
1 | 0.000 | 2026-09-07T08:28:13.997 | 0.0
2 | 0.000 | 2026-09-07T08:28:14.189 | 0.0
3 | 0.000 | 2026-09-07T08:28:14.381 | 0.0
4 | 0.000 | 2026-09-07T08:28:14.588 | 0.0
5 | 0.000 | 2026-09-07T08:28:14.781 | 0.0
6 | 0.000 | 2026-09-07T08:28:14.988 | 0.0
7 | 0.000 | 2026-09-07T08:28:15.180 | 0.0
8 | 0.000 | 2026-09-07T08:28:15.387 | 0.0
9 | 0.000 | 2026-09-07T08:28:15.579 | 0.0
10 | 0.000 | 2026-09-07T08:28:15.787 | 0.0
11 | 0.000 | 2026-09-07T08:28:15.979 | 0.0
12 | 0.000 | 2026-09-07T08:28:16.171 | 0.0
13 | 0.000 | 2026-09-07T08:28:16.379 | 0.0
14 | 0.000 | 2026-09-07T08:28:16.570 | 0.0
15 | 0.000 | 2026-09-07T08:28:16.778 | 0.0
16 | 0.000 | 2026-09-07T08:28:16.970 | 0.0
17 | 0.000 | 2026-09-07T08:28:17.178 | 0.0
18 | 0.000 | 2026-09-07T08:28:17.370 | 0.0
19 | 0.000 | 2026-09-07T08:28:17.578 | 0.0
20 | 0.000 | 2026-09-07T08:28:17.770 | 0.0
21 | 0.000 | 2026-09-07T08:28:17.961 | 0.0
22 | 0.001 | 2026-09-07T08:28:18.169 | 0.0
23 | 0.001 | 2026-09-07T08:28:18.361 | 0.0
24 | 0.001 | 2026-09-07T08:28:18.569 | 0.0
25 | 0.001 | 2026-09-07T08:28:18.761 | 0.0
26 | 0.001 | 2026-09-07T08:28:18.968 | 0.0
27 | 0.001 | 2026-09-07T08:28:19.160 | 0.0
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
