FrissieKris/Eng_DesignProject_GantryCrane_Group-18/MCTR/Juan_Fourie/GearTesting_Checkpoint1/Report/Jupyter/Data/PETG_Test1.csv

sample_no | elapsed_s | timestamp | load_kg
1 | 0 | 2026-09-08T14:24:35.193 | 0.3
2 | 0 | 2026-09-08T14:24:35.385 | 0.3
3 | 0 | 2026-09-08T14:24:35.592 | 0.3
4 | 0 | 2026-09-08T14:24:35.784 | 0.5
5 | 0 | 2026-09-08T14:24:35.990 | 0.6
6 | 0 | 2026-09-08T14:24:36.184 | 1.1
7 | 0 | 2026-09-08T14:24:36.377 | 2.8
8 | 0 | 2026-09-08T14:24:36.578 | 3.8
9 | 0 | 2026-09-08T14:24:36.775 | 2.9
10 | 0 | 2026-09-08T14:24:36.983 | 1.7
11 | 0 | 2026-09-08T14:24:37.175 | 0.8
12 | 0 | 2026-09-08T14:24:37.383 | 0.3
13 | 0 | 2026-09-08T14:24:37.575 | 0.2
14 | 0 | 2026-09-08T14:24:37.782 | 0.1
15 | 0 | 2026-09-08T14:24:37.975 | 0.1
16 | 0 | 2026-09-08T14:24:38.165 | 0.1
17 | 0 | 2026-09-08T14:24:38.374 | 0
18 | 0 | 2026-09-08T14:24:38.566 | 0
19 | 0.047 | 2026-09-08T14:24:38.773 | 0
20 | 0.047 | 2026-09-08T14:24:38.966 | 0
21 | 0.047 | 2026-09-08T14:24:39.173 | 0
22 | 0.047 | 2026-09-08T14:24:39.365 | 0
23 | 0.047 | 2026-09-08T14:24:39.565 | 0
24 | 0.047 | 2026-09-08T14:24:39.764 | 0
25 | 0.047 | 2026-09-08T14:24:39.951 | 0.1
26 | 0.047 | 2026-09-08T14:24:40.163 | 0
27 | 0.047 | 2026-09-08T14:24:40.353 | 0
28 | 0.047 | 2026-09-08T14:24:40.564 | 0
29 | 0.047 | 2026-09-08T14:24:40.755 | 0
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
