FrissieKris/Eng_DesignProject_GantryCrane_Group-18/MCTR/Juan_Fourie/GearTesting_Checkpoint1/Report/Jupyter/Data/PETG_Test2.csv

sample_no | elapsed_s | timestamp | load_kg
1 | 0.000 | 2026-09-08T14:29:44.738 | 0.2
2 | 0.000 | 2026-09-08T14:29:44.931 | 0.2
3 | 0.000 | 2026-09-08T14:29:45.138 | 0.1
4 | 0.000 | 2026-09-08T14:29:45.330 | 0.1
5 | 0.000 | 2026-09-08T14:29:45.537 | 0.1
6 | 0.000 | 2026-09-08T14:29:45.729 | 0.1
7 | 0.000 | 2026-09-08T14:29:45.937 | 0.1
8 | 0.000 | 2026-09-08T14:29:46.129 | 0.1
9 | 0.000 | 2026-09-08T14:29:46.337 | 0.1
10 | 0.000 | 2026-09-08T14:29:46.529 | 0.2
11 | 0.000 | 2026-09-08T14:29:46.721 | 0.1
12 | 0.000 | 2026-09-08T14:29:46.928 | 0.1
13 | 0.000 | 2026-09-08T14:29:47.120 | 0.1
14 | 0.000 | 2026-09-08T14:29:47.328 | 0.1
15 | 0.000 | 2026-09-08T14:29:47.520 | 0.1
16 | 0.000 | 2026-09-08T14:29:47.728 | 0.1
17 | 0.000 | 2026-09-08T14:29:47.919 | 0.1
18 | 0.000 | 2026-09-08T14:29:48.127 | 0.1
19 | 0.047 | 2026-09-08T14:29:48.319 | 0.1
20 | 0.047 | 2026-09-08T14:29:48.527 | 0.1
21 | 0.047 | 2026-09-08T14:29:48.717 | 0.1
22 | 0.047 | 2026-09-08T14:29:48.907 | 0.1
23 | 0.047 | 2026-09-08T14:29:49.117 | 0.1
24 | 0.047 | 2026-09-08T14:29:49.305 | 0.1
25 | 0.047 | 2026-09-08T14:29:49.510 | 0.1
26 | 0.047 | 2026-09-08T14:29:49.708 | 0.1
27 | 0.047 | 2026-09-08T14:29:49.914 | 0.1
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
