FrissieKris/Eng_DesignProject_GantryCrane_Group-18/MCTR/Juan_Fourie/GearTesting_Checkpoint1/Report/Jupyter/Data/PLA_Test1.csv

sample_no | elapsed_s | timestamp | load_kg
1 | 0 | 2026-09-08T15:04:25.846 | 0
2 | 0 | 2026-09-08T15:04:26.039 | 0
3 | 0 | 2026-09-08T15:04:26.246 | 0
4 | 0 | 2026-09-08T15:04:26.437 | 0
5 | 0 | 2026-09-08T15:04:26.645 | 0
6 | 0 | 2026-09-08T15:04:26.837 | 0.3
7 | 0 | 2026-09-08T15:04:27.045 | 0.5
8 | 0 | 2026-09-08T15:04:27.237 | 0.9
9 | 0 | 2026-09-08T15:04:27.429 | 1
10 | 0 | 2026-09-08T15:04:27.637 | 0.8
11 | 0 | 2026-09-08T15:04:27.828 | 0.7
12 | 0 | 2026-09-08T15:04:28.036 | 0.7
13 | 0 | 2026-09-08T15:04:28.228 | 0.6
14 | 0 | 2026-09-08T15:04:28.436 | 0.7
15 | 0 | 2026-09-08T15:04:28.628 | 0.6
16 | 0 | 2026-09-08T15:04:28.828 | 0.6
17 | 0 | 2026-09-08T15:04:29.027 | 0.5
18 | 0 | 2026-09-08T15:04:29.217 | 0.6
19 | 0.047 | 2026-09-08T15:04:29.422 | 0.6
20 | 0.047 | 2026-09-08T15:04:29.612 | 0.6
21 | 0.047 | 2026-09-08T15:04:29.823 | 0.6
22 | 0.047 | 2026-09-08T15:04:30.018 | 0.6
23 | 0.047 | 2026-09-08T15:04:30.224 | 0.6
24 | 0.047 | 2026-09-08T15:04:30.417 | 0.6
25 | 0.047 | 2026-09-08T15:04:30.625 | 0.6
26 | 0.047 | 2026-09-08T15:04:30.817 | 0.6
27 | 0.047 | 2026-09-08T15:04:31.023 | 0.6
28 | 0.047 | 2026-09-08T15:04:31.213 | 0.6
29 | 0.047 | 2026-09-08T15:04:31.401 | 0.6
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
