FrissieKris/Eng_DesignProject_GantryCrane_Group-18/MCTR/Juan_Fourie/GearTesting_Checkpoint1/Report/Jupyter/Data/PLA_Test2.csv

sample_no | elapsed_s | timestamp | load_kg
1 | 0 | 2026-09-08T15:37:32.646 | 0.8
2 | 0 | 2026-09-08T15:37:32.854 | 0.8
3 | 0 | 2026-09-08T15:37:33.040 | 0.8
4 | 0 | 2026-09-08T15:37:33.253 | 0.9
5 | 0 | 2026-09-08T15:37:33.445 | 1.4
6 | 0 | 2026-09-08T15:37:33.653 | 1.7
7 | 0 | 2026-09-08T15:37:33.841 | 1.8
8 | 0 | 2026-09-08T15:37:34.036 | 1.6
9 | 0 | 2026-09-08T15:37:34.242 | 1.3
10 | 0 | 2026-09-08T15:37:34.436 | 1.1
11 | 0 | 2026-09-08T15:37:34.643 | 0.9
12 | 0 | 2026-09-08T15:37:34.835 | 0.5
13 | 0 | 2026-09-08T15:37:35.042 | 0.2
14 | 0 | 2026-09-08T15:37:35.234 | 0.1
15 | 0 | 2026-09-08T15:37:35.440 | 0.1
16 | 0 | 2026-09-08T15:37:35.634 | 0.1
17 | 0 | 2026-09-08T15:37:35.842 | 0.1
18 | 0 | 2026-09-08T15:37:36.034 | 0.1
19 | 0.047 | 2026-09-08T15:37:36.224 | 0.1
20 | 0.047 | 2026-09-08T15:37:36.431 | 0.1
21 | 0.047 | 2026-09-08T15:37:36.626 | 0.1
22 | 0.047 | 2026-09-08T15:37:36.833 | 0.1
23 | 0.047 | 2026-09-08T15:37:37.025 | 0.1
24 | 0.047 | 2026-09-08T15:37:37.233 | 0.1
25 | 0.047 | 2026-09-08T15:37:37.425 | 0.1
26 | 0.047 | 2026-09-08T15:37:37.632 | 0.1
27 | 0.047 | 2026-09-08T15:37:37.824 | 0.2
28 | 0.047 | 2026-09-08T15:37:38.016 | 0.2
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
