FrissieKris/Eng_DesignProject_GantryCrane_Group-18/EngineeringDesign_Group18_Report/figures/Figure_5_5_Radio_Performance.png

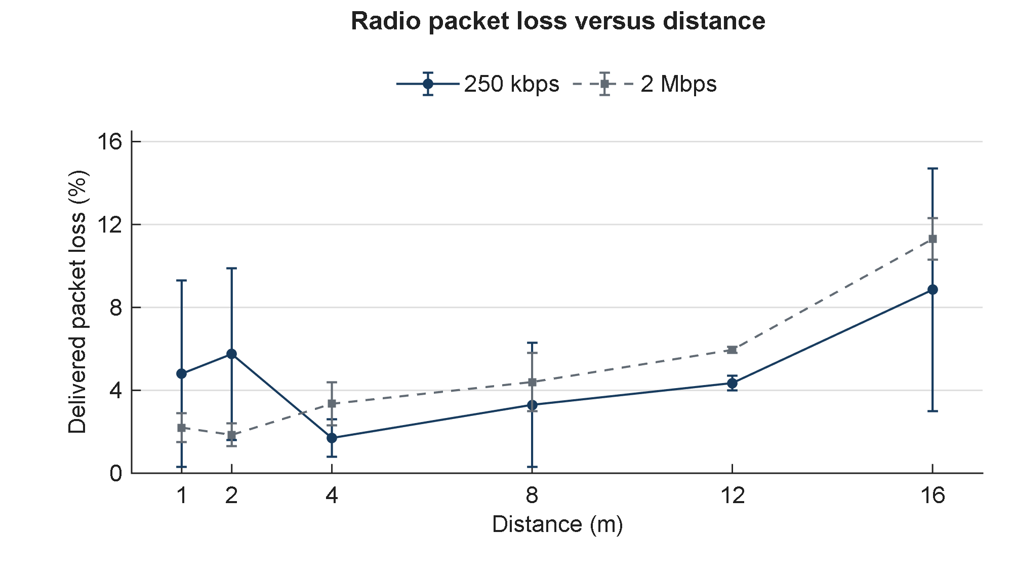
EngineeringDesign_Group18_Report/figures/Figure_5_5_Radio_Performance.png
