FrissieKris/Eng_DesignProject_GantryCrane_Group-18/EngineeringDesign_Group18_Report/figures/Opto_coupler_test.jpeg

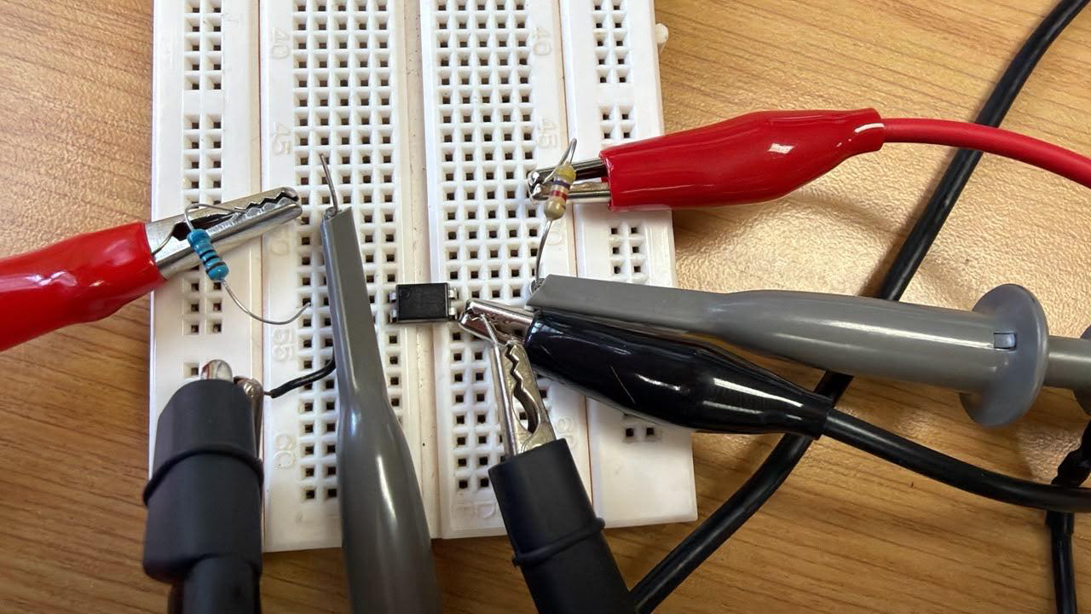
EngineeringDesign_Group18_Report/figures/Opto_coupler_test.jpeg
