FrissieKris/Eng_DesignProject_GantryCrane_Group-18/EngineeringDesign_Group18_Report/figures/Opto_results.jpeg

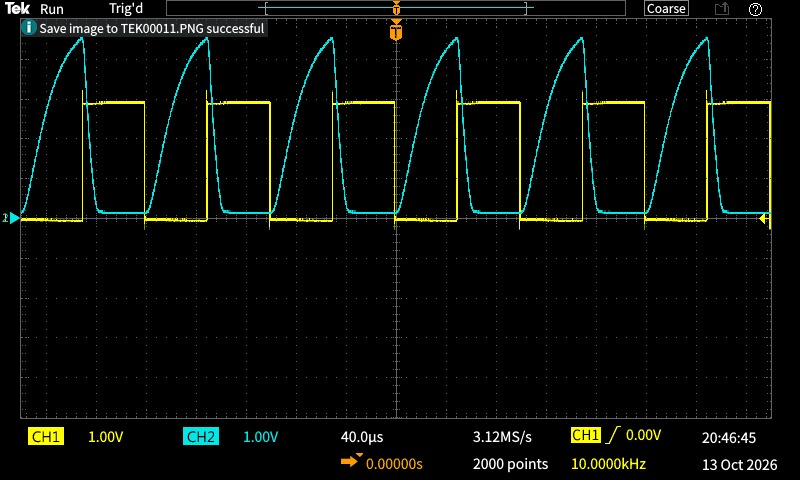
EngineeringDesign_Group18_Report/figures/Opto_results.jpeg
