FrissieKris/Eng_DesignProject_GantryCrane_Group-18/EngineeringDesign_Group18_Report/content/B_risk_register.tex

% ============================================================
%  APPENDIX B – RISK REGISTER
% ============================================================
\chapter{Risk Register}
\label{app:risk}

\begin{figure}[H]
    \centering
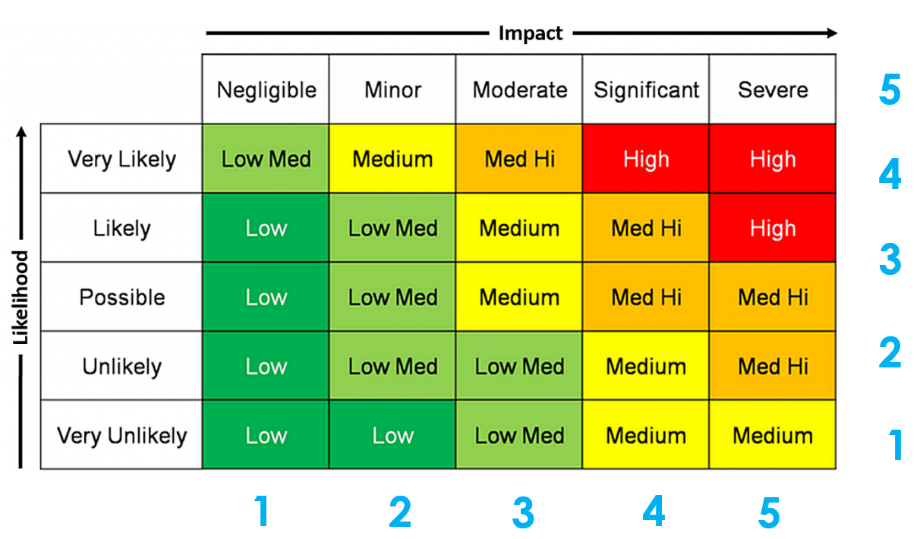
[picture p37: EngineeringDesign_Group18_Report/img/App_RiskEvaluation_Matrix.png]
    
    \caption{Risk Evaluation Matrix used to determine risk severity \cite{Risk_Eval_Table}.}
    \label{app:risk-eval-table}
\end{figure}

\rowcolors{1}{gray!25}{white}
\begin{table}[H]
    \centering

    \caption{Risk identification and management.}
    \label{tab:risk-register}
    \begin{tabular}{@{} l p{4cm} p{4.5cm} p{8cm} @{}}
        \toprule
        \textbf{ID} & \textbf{Risk description}
                    & \textbf{Likelihood and Impact}
                    & \textbf{Mitigation strategy}                                                                    \\
        \midrule
        S1          & Late Component Delivery
                    & Possible; Significant
                    & Determine and order components 2 weeks ahead of time; look for local suppliers.                 \\
        S2          & Component Failure
                    & Likely; Significant
                    & Acquire spares where reasonable and obtain quality suppliers.  \\
        G1          & Member does not adhere to responsibilities
                    & Possible; Significant
                    & Perform weekly check-ins, work management, and performance measures.                            \\
        G2          & Member's attention required elsewhere, e.g. death or disaster.
                    & Possible; Severe
                    & Communicate possible interferences with group responsibilities and plan accordingly.            \\
        K1          & Tool ignorance e.g. CAD, Simulink, Git, Codebase.
                    & Very Likely; Significant                                                                                      
                    & Share knowledge of tools with other members and learn from tutorials as required.               \\
        K2          & Ignorance regarding components
                    & Very Likely; Significant                                                                                     
                    & Rely on familiar experience and components; consult resources to learn of new ones required.    \\
        P1          & Integration failure of subsystems 
                    & Possible, Severe
                    & Have clear documentation of subsystems, tests and confirmation during development.                                \\
        L1          & Workshop / Lab Access Conflicts 
                    & Very Likely; Significant
                    & Make use of members' tools or organise with other acquantances who have 3D printers or fabrication facilities. \\
        L2          & Poor Documentation and Traceability Problems          
                    & Very Likely; Significant 
                    & Use shared GitHub repository with version control of all files and drawings with naming conventions.   \\
        \bottomrule
    \end{tabular}
\end{table}

\begin{table}[H]
    \centering
    \caption{Risk traceability matrix \textbf{BEFORE} mitigation.}
    \label{tab:risk-before}
    \renewcommand{\arraystretch}{1.4}
    \begin{tabular}{@{} l | c c c c c @{}}
        \toprule
                            & \multicolumn{5}{c}{\textbf{Impact}}                                                    \\
        \textbf{Likelihood} & \textbf{1 – Negligible}             & \textbf{2 – Minor}
                            & \textbf{3 – Moderate}               & \textbf{4 – Major} & \textbf{5 – Severe}         \\
        \midrule
        5 – Very high       &                                     &                    &                     &     & \\
        4 – High            &                                     &                    &                     & R01 & \\
        3 – Medium          &                                     &                    & R03                 &     & \\
        2 – Low             &                                     &                    &                     & R02 & \\
        1 – Very low        &                                     &                    &                     &     & \\
        \bottomrule
    \end{tabular}
\end{table}

\begin{table}[H]
    \centering
    \caption{Risk traceability matrix \textbf{AFTER} mitigation.}
    \label{tab:risk-after}
    \renewcommand{\arraystretch}{1.4}
    \begin{tabular}{@{} l | c c c c c @{}}
        \toprule
                            & \multicolumn{5}{c}{\textbf{Impact}}                                                 \\
        \textbf{Likelihood} & \textbf{1 – Negligible}             & \textbf{2 – Minor}
                            & \textbf{3 – Moderate}               & \textbf{4 – Major} & \textbf{5 – Severe}      \\
        \midrule
        5 – Very high       &                                     &                    &                     &  & \\
        4 – High            &                                     &                    &                     &  & \\
        3 – Medium          &                                     & R01                & R02                 &  & \\
        2 – Low             &                                     & R03                &                     &  & \\
        1 – Very low        &                                     &                    &                     &  & \\
        \bottomrule
    \end{tabular}
\end{table}
