FrissieKris/Eng_DesignProject_GantryCrane_Group-18/Specifications/Risk_Traceability_Matrix.xlsx

Risk Traceability Matrix BEFORE Mitigation
Risk Codes | Schedule Risk Likelihood | Schedule Risk Impact | Group Risk Impact | Group Risk Likelihood | Knowledge Risk Likelihood | Knowledge Risk Impact | Integration Risk Likelihood | Integration Risk Impact | Logistical Risk Likelihood | Logistical Risk Impact | Schedule Risk Score | Group Risk Score | Knowledge Risk Score | Integration Risk Score | Logistic Risk Score
S1 | 5 | 4 |  |  |  |  |  |  |  |  | 20
S2 | 4 | 4 |  |  |  |  |  |  |  |  | 16
G1 |  |  | 3 | 4 |  |  |  |  |  |  |  | 12
G2 |  |  | 3 | 5 |  |  |  |  |  |  |  | 15
K1 |  |  |  |  | 5 | 4 |  |  |  |  |  |  | 20
K2 |  |  |  |  | 5 | 4 |  |  |  |  |  |  | 20
P1 |  |  |  |  |  |  | 3 | 5 |  |  |  |  |  | 15
L1 |  |  |  |  |  |  |  |  | 5 | 4 |  |  |  |  | 20
L2 |  |  |  |  |  |  |  |  | 5 | 4 |  |  |  |  | 20
Score legend:
 | 1 – 4 Low risk
 | 5 – 9 Moderate risk
 | 10 – 14 High risk
 | ≥ 15 Critical risk
Instructions: Fill in Likelihood (1–5) and Impact (1–5) values in the light-blue cells. Leave cells blank if that risk category does not apply to the risk code. Score = Likelihood × Impact and is coloured automatically.
Risk Traceability Matrix AFTER Mitigation
Risk Codes | Schedule Risk Likelihood | Schedule Risk Impact | Group Risk Impact | Group Risk Likelihood | Knowledge Risk Likelihood | Knowledge Risk Impact | Integration Risk Likelihood | Integration Risk Impact | Logistical Risk Likelihood | Logistical Risk Impact | Schedule Risk Score | Group Risk Score | Knowledge Risk Score | Integration Risk Score | Logistic Risk Score
S1 | 4 | 3 |  |  |  |  |  |  |  |  | 12
S2 | 2 | 3 |  |  |  |  |  |  |  |  | 6
G1 |  |  | 2 | 3 |  |  |  |  |  |  |  | 6
G2 |  |  | 2 | 5 |  |  |  |  |  |  |  | 10
K1 |  |  |  |  | 2 | 2 |  |  |  |  |  |  | 4
K2 |  |  |  |  | 2 | 2 |  |  |  |  |  |  | 4
P1 |  |  |  |  |  |  | 2 | 4 |  |  |  |  |  | 8
L1 |  |  |  |  |  |  |  |  | 2 | 2 |  |  |  |  | 4
L2 |  |  |  |  |  |  |  |  | 3 | 3 |  |  |  |  | 9
Score legend:
 | 1 – 4 Low risk
 | 5 – 9 Moderate risk
 | 10 – 14 High risk
 | ≥ 15 Critical risk
Instructions: Fill in Likelihood (1–5) and Impact (1–5) values in the light-blue cells. Leave cells blank if that risk category does not apply to the risk code. Score = Likelihood × Impact and is coloured automatically.
 |  |  |  |  |  |  |  |  |  |  |  |  |  |  |  | NWU Risk Traceability Matrix – How to Use
 |  |  |  |  |  |  |  |  |  |  |  |  |  |  |  | Risk Codes | Enter a unique identifier for each risk (e.g. S1, S2 for Schedule risks; L1 for Logistic; T1, T2 for Technical; K1, K2 for Knowledge). Add rows by copying a data row down.
 |  |  |  |  |  |  |  |  |  |  |  |  |  |  |  | Likelihood (1–5) | Rate how likely the risk is to occur: 1 = Very Low 2 = Low 3 = Medium 4 = High 5 = Very High
 |  |  |  |  |  |  |  |  |  |  |  |  |  |  |  | Impact (1–5) | Rate the consequence if the risk materialises: 1 = Negligible 2 = Minor 3 = Moderate 4 = Major 5 = Severe
 |  |  |  |  |  |  |  |  |  |  |  |  |  |  |  | Score (auto) | Calculated automatically as Likelihood × Impact. The cell colour updates via conditional formatting: Green (1–4): Low Yellow (5–9): Moderate Orange (10–14): High Red (≥15): Critical
 |  |  |  |  |  |  |  |  |  |  |  |  |  |  |  | Blank cells | Leave a cell blank if that risk category does not apply to that risk code. The score cell will remain empty automatically.
 |  |  |  |  |  |  |  |  |  |  |  |  |  |  |  | BEFORE / AFTER sheets | Fill in BEFORE Mitigation first. After defining mitigations, copy the risk codes to AFTER Mitigation and enter the revised likelihood and impact values to show the improvement.
 |  |  |  |  |  |  |  |  |  |  |  |  |  |  |  | Adding rows | Click the last data row, copy it (Ctrl+C), then paste below. All formulas and formatting will be replicated. Update the Risk Code in column A.
 |  |  |  |  |  |  |  |  |  |  |  |  |  |  |  | Excel2LaTeX export | To embed this table in your LaTeX report: install the Excel2LaTeX add-in, select the table range, and click Convert to LaTeX. Paste the output into content/B_risk_register.tex.
 |  |  |  |  |  |  |  |  |  |  |  |  |  |  |  | Score colour scale:
 |  |  |  |  |  |  |  |  |  |  |  |  |  |  |  | 1 – 4 Low risk
 |  |  |  |  |  |  |  |  |  |  |  |  |  |  |  | 5 – 9 Moderate risk
 |  |  |  |  |  |  |  |  |  |  |  |  |  |  |  | 10 – 14 High risk
 |  |  |  |  |  |  |  |  |  |  |  |  |  |  |  | ≥ 15 Critical risk
