FrissieKris/Eng_DesignProject_GantryCrane_Group-18/EngineeringDesign_Group18_Report/tables/Tab_RiskTraceabilityMatrix_Legend.png

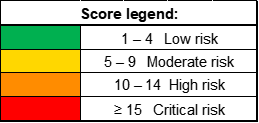
EngineeringDesign_Group18_Report/tables/Tab_RiskTraceabilityMatrix_Legend.png
