FrissieKris/Eng_DesignProject_GantryCrane_Group-18/Orders Placed/RSElectronics/Fourie_50128523_RSElectronics_Order.pdf

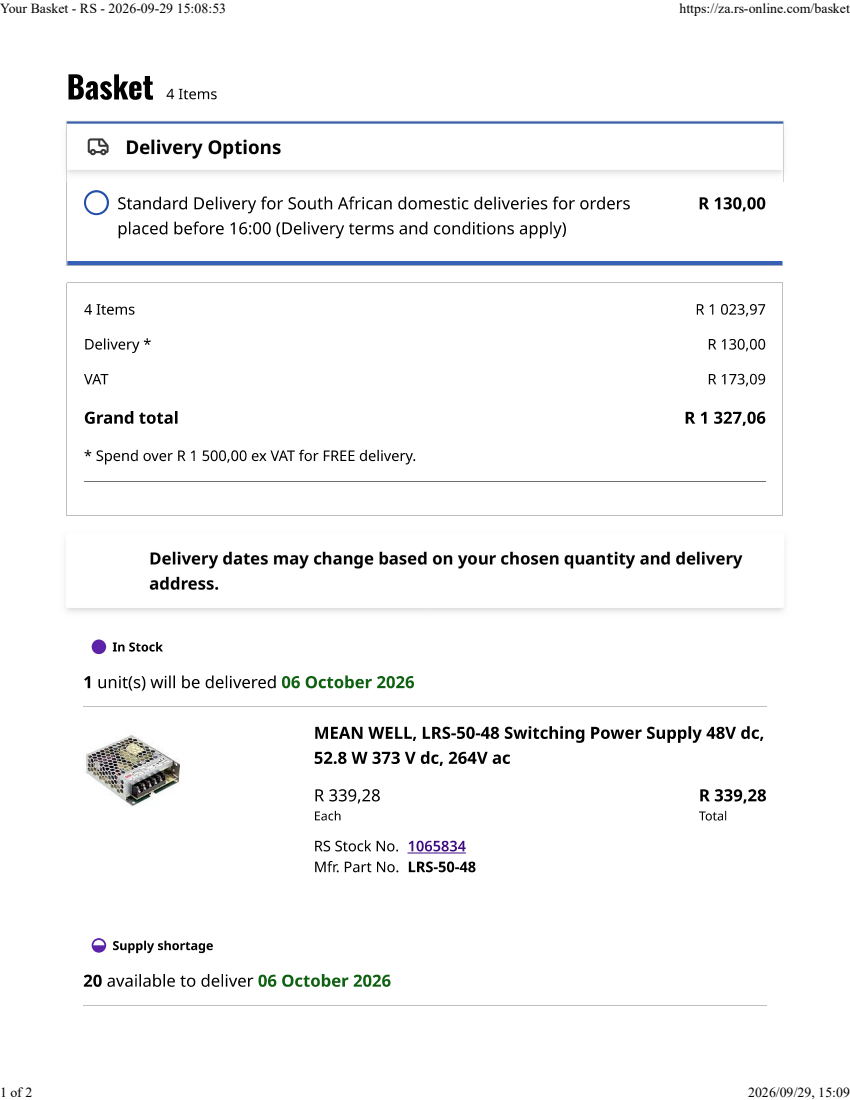
[picture p40: page 1]
Your Basket - RS - 2026-09-29 15:08:53; https://za.rs-online.com/basket

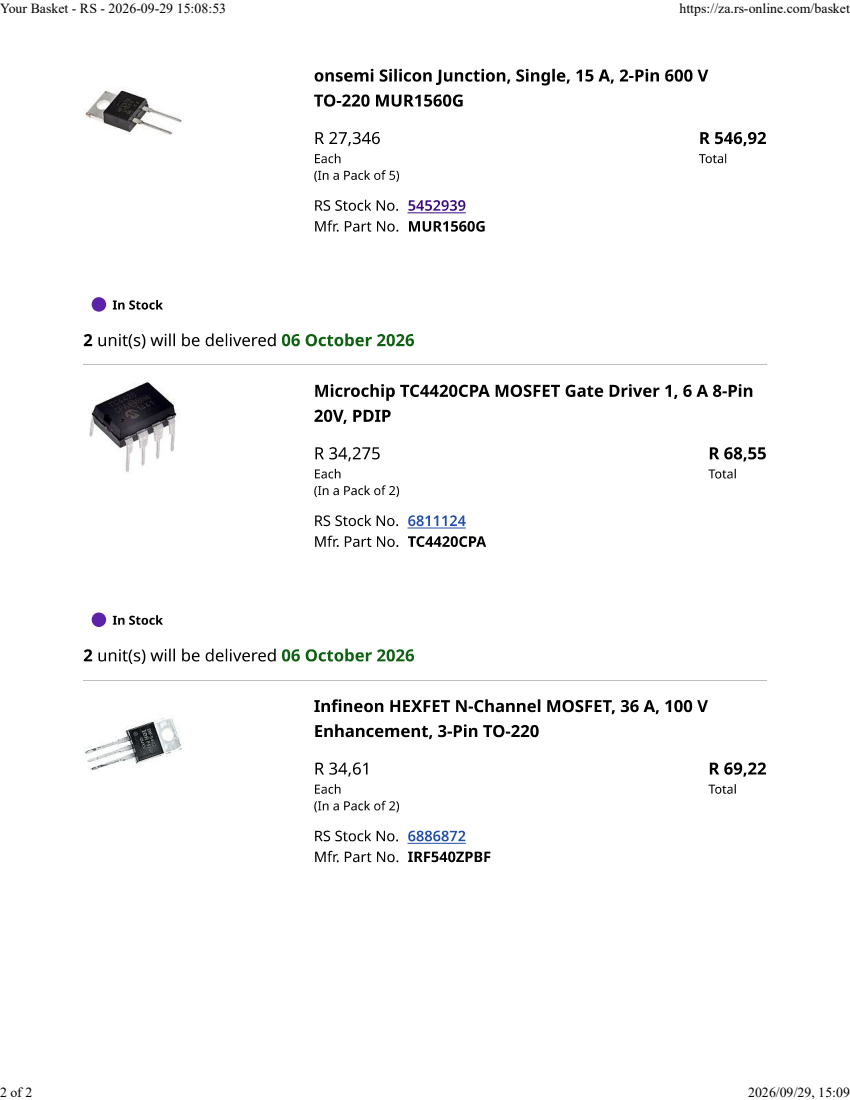
[picture p41: page 2]
Your Basket - RS - 2026-09-29 15:08:53; https://za.rs-online.com/basket
