FrissieKris/Eng_DesignProject_GantryCrane_Group-18/(commit log)

2026-08-16 Added Risk Traceability Matrix first draft with blank excel template for the before and after mitigation.
2026-08-23 Added main draw.io file with System Life Cycle Flow Chart
    Added the main draw.io file that will be used for all the flowcharts and diagrams. Completed first rendition of the System Life Cycle Flowchart. Also made minor changes to the risk traceability matrix but should still be finished.
2026-09-07 MCTRII Gear Train Calculations and Test Gear
    Created First Gear Train Calculations and made first gear for testing on the rig.
2026-10-22 Added Flowcharts and Diagrams for Group Access
    Added level 0 and level 1 drawings to be used as reference and edited if needed.
2026-10-22 preliminary ESP32 radio test appendix
